JaimeBravoAlgaba/Helios_SoftRobot/Media/Imágenes/Sensor/WaveGuides/MatlabAnalysis/Core_45.png

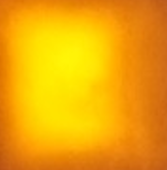
Media/Imágenes/Sensor/WaveGuides/MatlabAnalysis/Core_45.png
