JaimeBravoAlgaba/Helios_SoftRobot/Media/Imágenes/Sensor/WaveGuides/MatlabAnalysis/Cladding_60.png

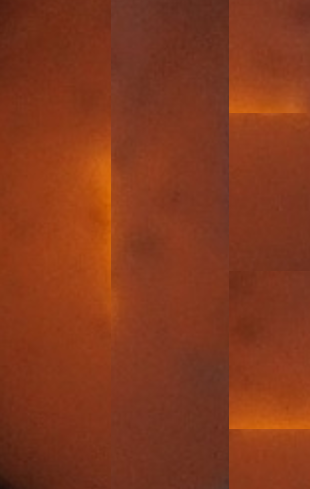
Media/Imágenes/Sensor/WaveGuides/MatlabAnalysis/Cladding_60.png
