JaimeBravoAlgaba/Helios_SoftRobot/Electrónica/Helios/Helios_PCB/Helios_emt/Helios_emt.png

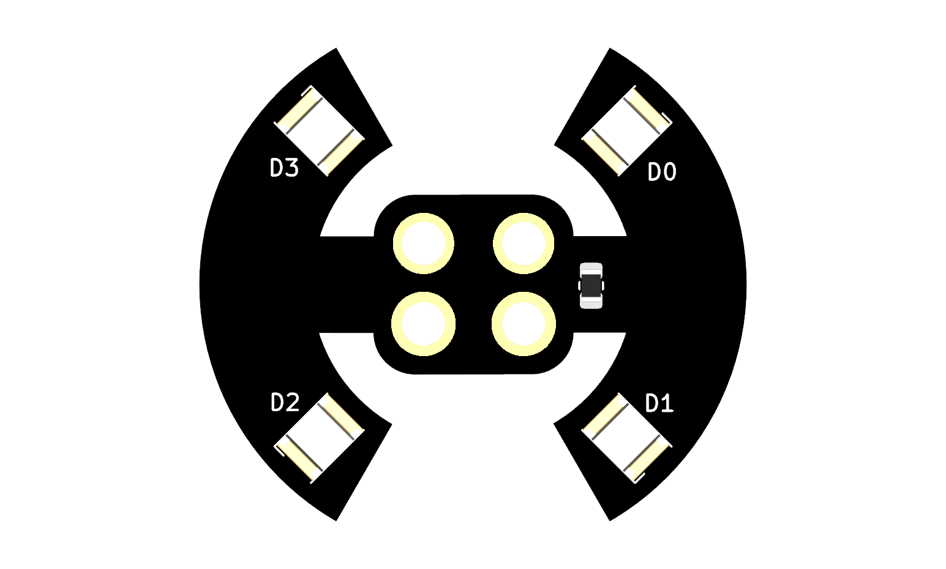
Electrónica/Helios/Helios_PCB/Helios_emt/Helios_emt.png
