JaimeBravoAlgaba/Helios_SoftRobot/Media/Imágenes/Actuator/HeliosActuator_explosionado.jpg

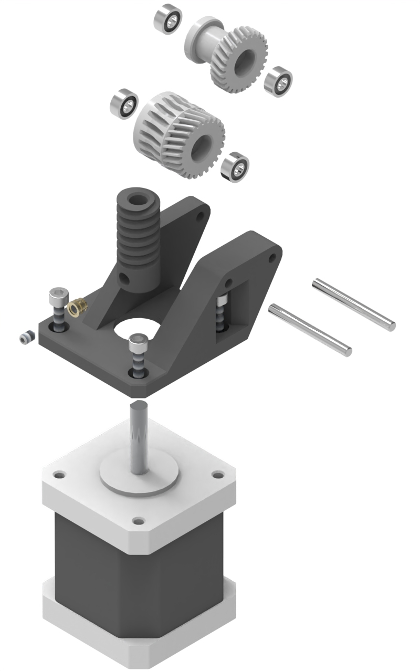
Media/Imágenes/Actuator/HeliosActuator_explosionado.jpg
