JaimeBravoAlgaba/Helios_SoftRobot/Media/Imágenes/Actuator/HeliosActuator_iso.jpg

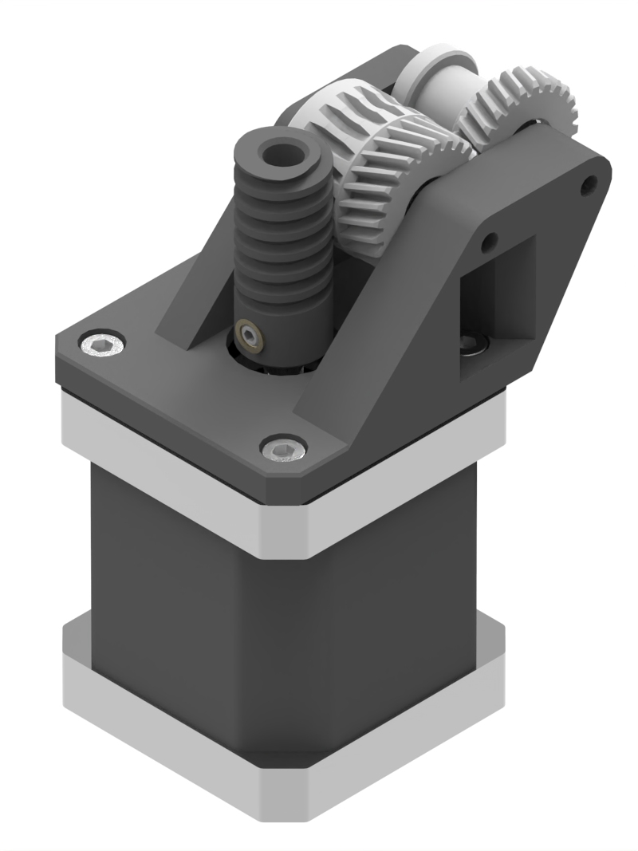
Media/Imágenes/Actuator/HeliosActuator_iso.jpg
