JaimeBravoAlgaba/Helios_SoftRobot/Media/Imágenes/Actuator/HeliosActuator_iso_2.jpg

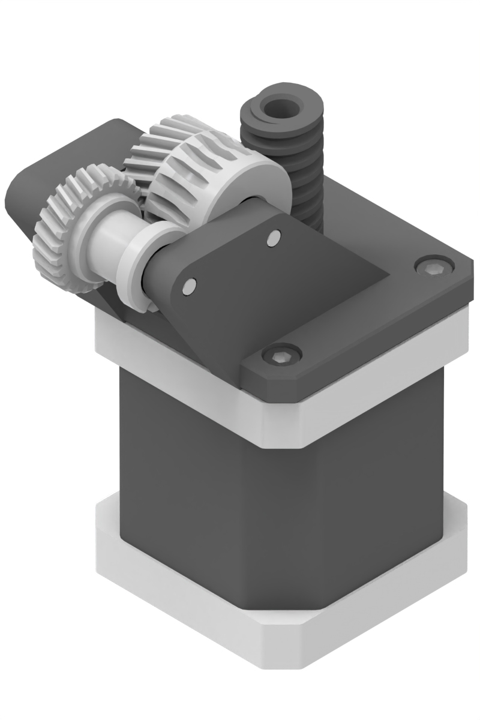
Media/Imágenes/Actuator/HeliosActuator_iso_2.jpg
