JaimeBravoAlgaba/Helios_SoftRobot/Media/Imágenes/Banco de Motores/BancodeMotores.jpg

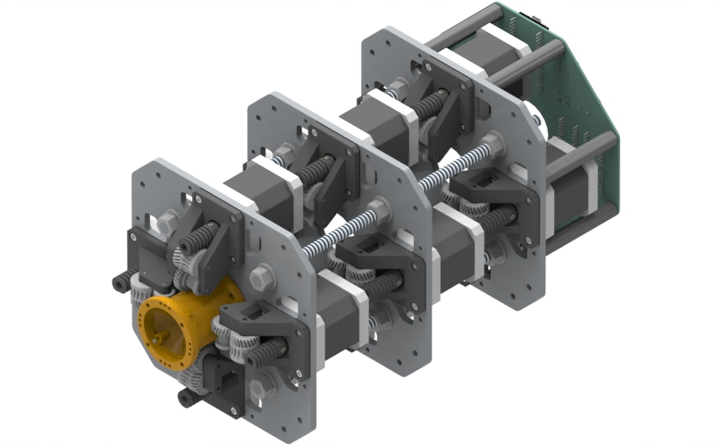
Media/Imágenes/Banco de Motores/BancodeMotores.jpg
