JaimeBravoAlgaba/Helios_SoftRobot/Media/Imágenes/Banco de Motores/BancodeMotores_back.jpg

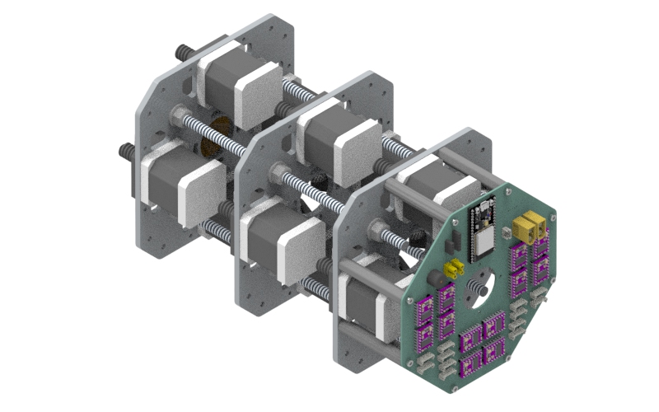
Media/Imágenes/Banco de Motores/BancodeMotores_back.jpg
