JaimeBravoAlgaba/Helios_SoftRobot/Media/Imágenes/HeliosPanel/Helios_PCB_panel.png

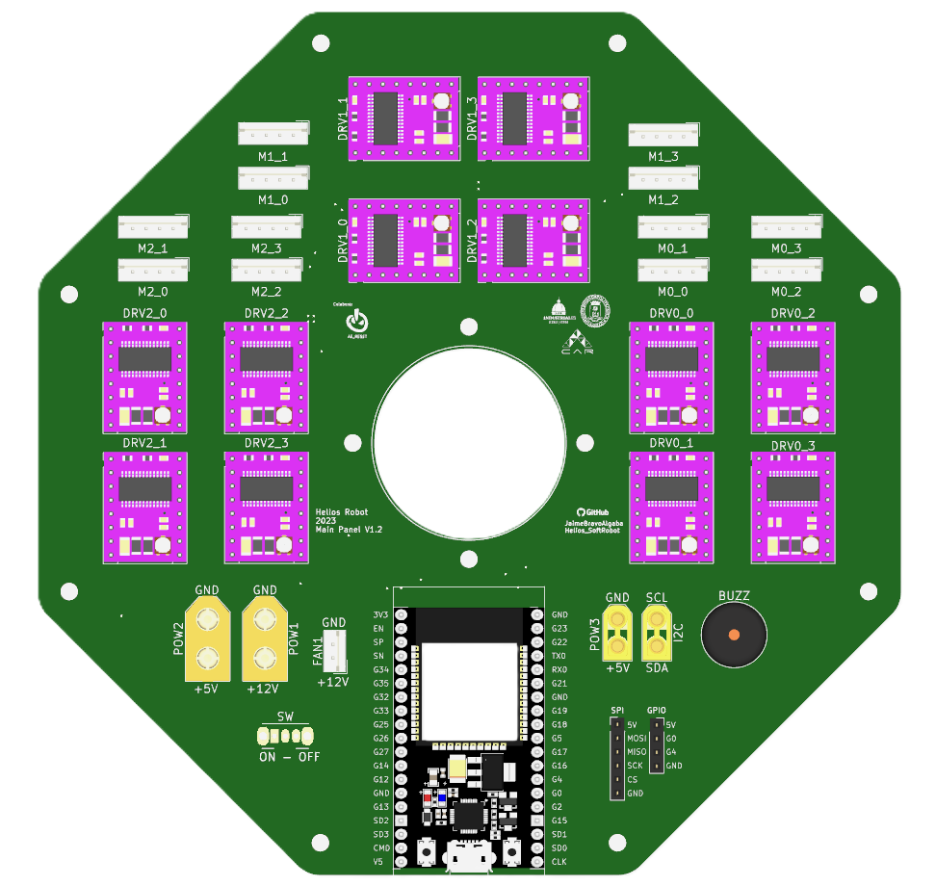
Media/Imágenes/HeliosPanel/Helios_PCB_panel.png
