JaimeBravoAlgaba/Helios_SoftRobot/Media/Imágenes/IMU/HeliosIMU.jpg

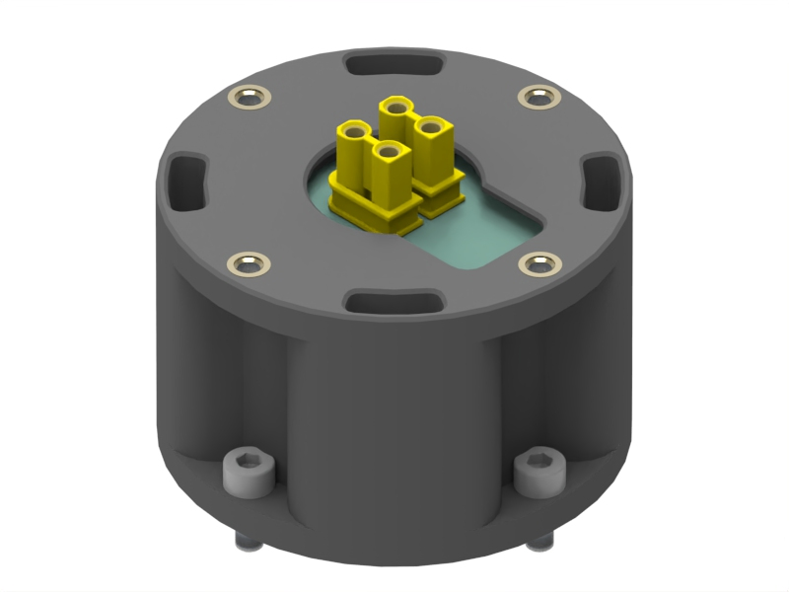
Media/Imágenes/IMU/HeliosIMU.jpg
