JaimeBravoAlgaba/Helios_SoftRobot/Media/Imágenes/IMU/HeliosIMU_exp.jpg

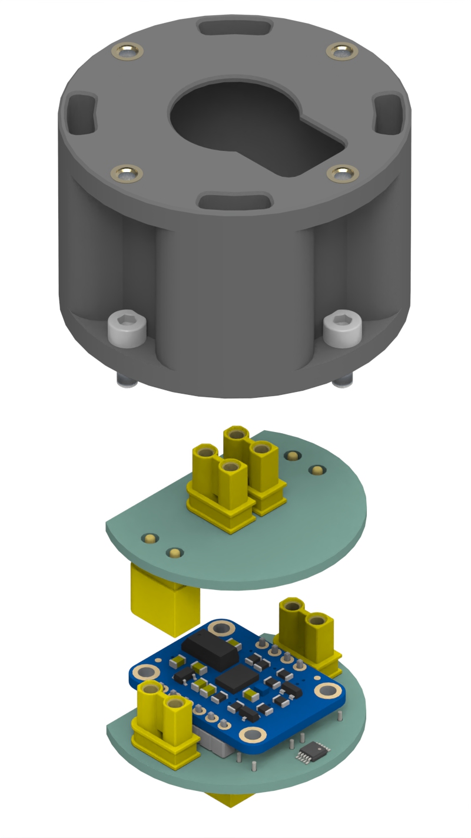
Media/Imágenes/IMU/HeliosIMU_exp.jpg
