JaimeBravoAlgaba/Helios_SoftRobot/Media/Imágenes/Sensor/DSC03742.JPG

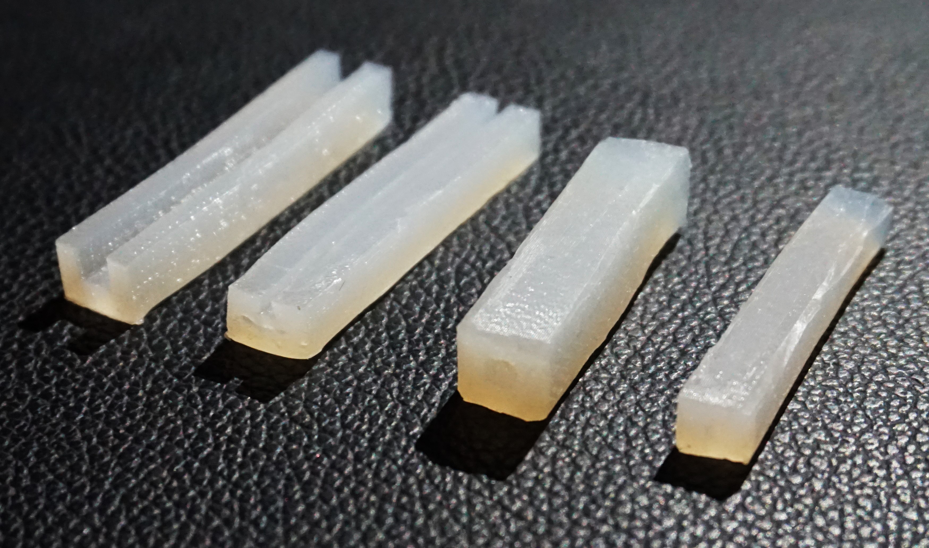
Media/Imágenes/Sensor/DSC03742.JPG
