JaimeBravoAlgaba/Helios_SoftRobot/Media/Imágenes/Sensor/explosionado.jpg

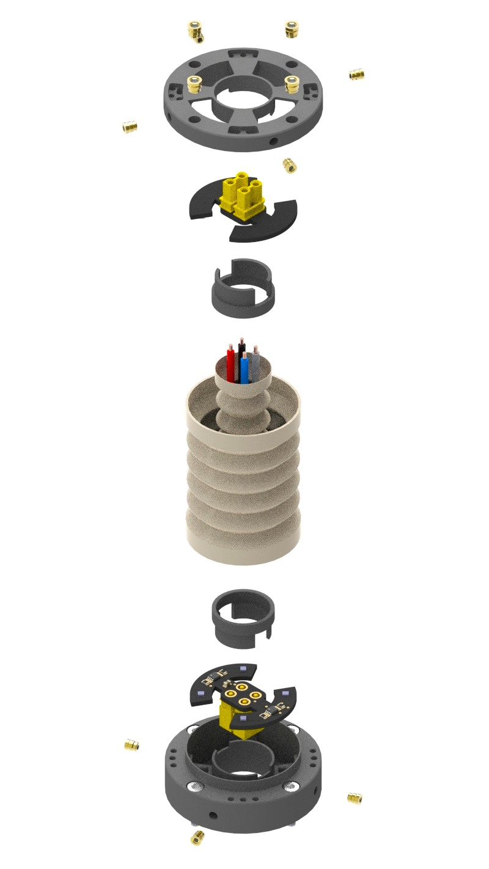
Media/Imágenes/Sensor/explosionado.jpg
