JaimeBravoAlgaba/Helios_SoftRobot/Media/Imágenes/Sensor/explosionado.png

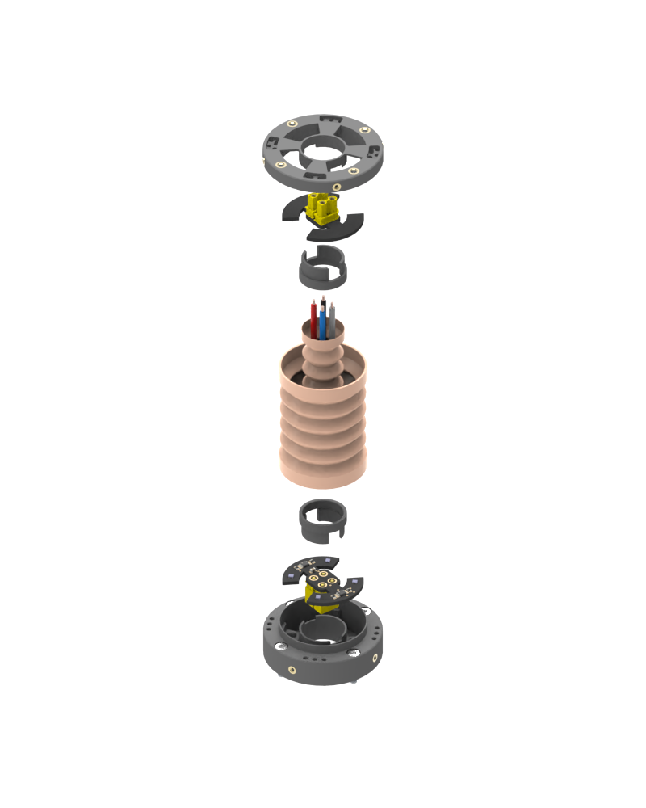
Media/Imágenes/Sensor/explosionado.png
