JaimeBravoAlgaba/Helios_SoftRobot/Media/Imágenes/Sensor/FuellesFlexibles.png

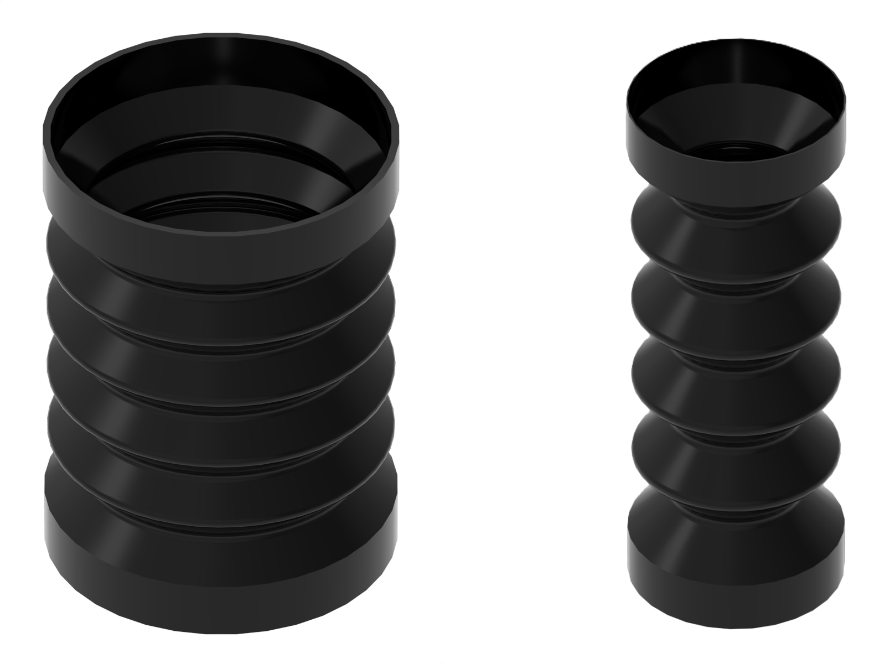
Media/Imágenes/Sensor/FuellesFlexibles.png
