JaimeBravoAlgaba/Helios_SoftRobot/Media/Imágenes/Sensor/Helios_emt/DiscoHembra_cut.jpg

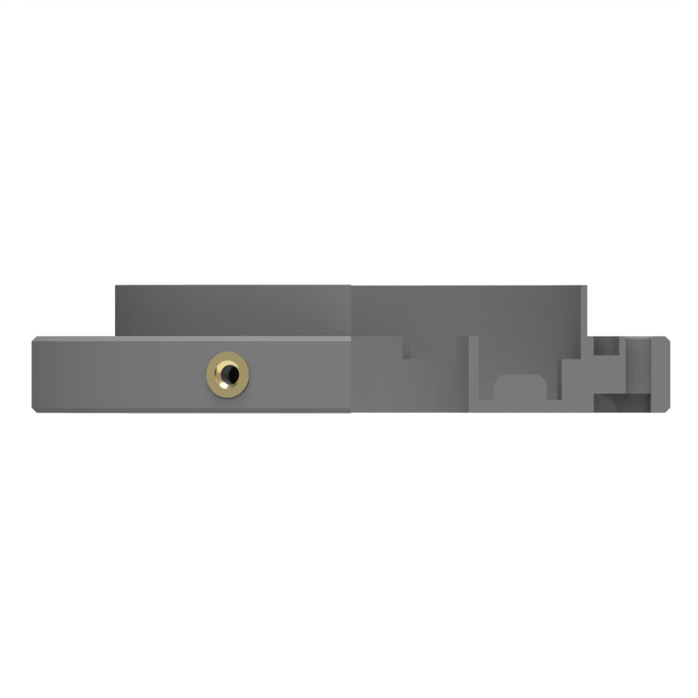
Media/Imágenes/Sensor/Helios_emt/DiscoHembra_cut.jpg
