JaimeBravoAlgaba/Helios_SoftRobot/Media/Imágenes/Sensor/Helios_emt/DiscoHembra_iso.jpg

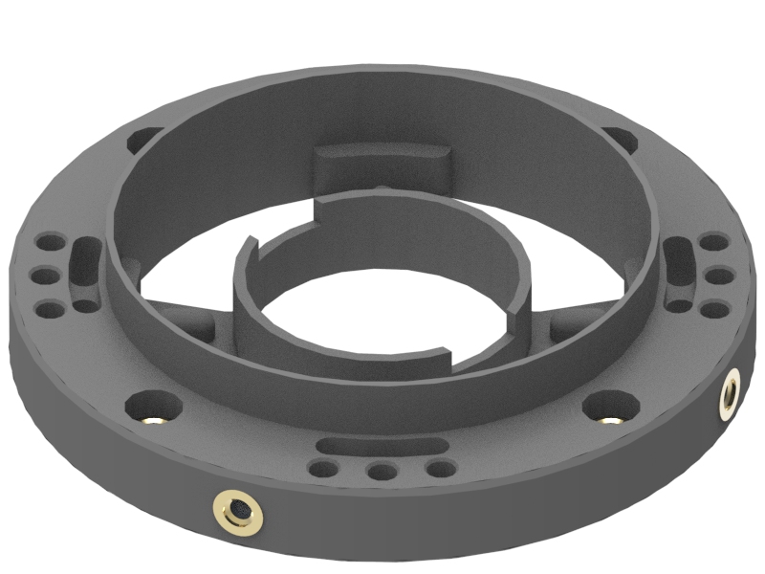
Media/Imágenes/Sensor/Helios_emt/DiscoHembra_iso.jpg
