JaimeBravoAlgaba/Helios_SoftRobot/Media/Imágenes/Sensor/Helios_emt/DiscoHembra_top.8.jpg

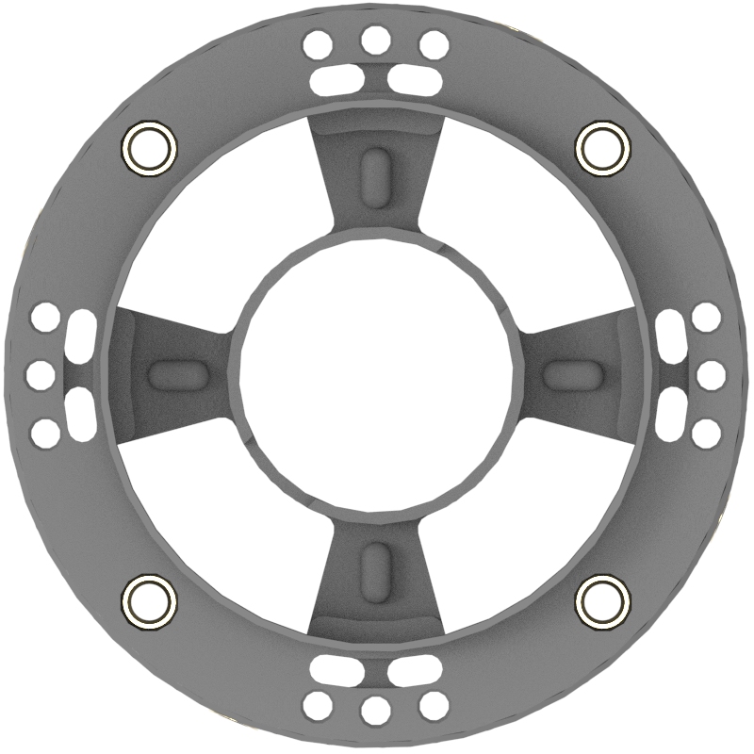
Media/Imágenes/Sensor/Helios_emt/DiscoHembra_top.8.jpg
