JaimeBravoAlgaba/Helios_SoftRobot/Media/Imágenes/Sensor/Helios_Iter2_Dims.png

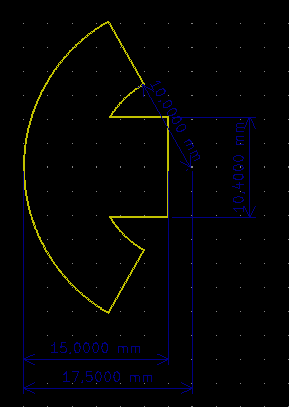
Media/Imágenes/Sensor/Helios_Iter2_Dims.png
