JaimeBravoAlgaba/Helios_SoftRobot/Media/Imágenes/Sensor/Helios_Module_Rev1.png

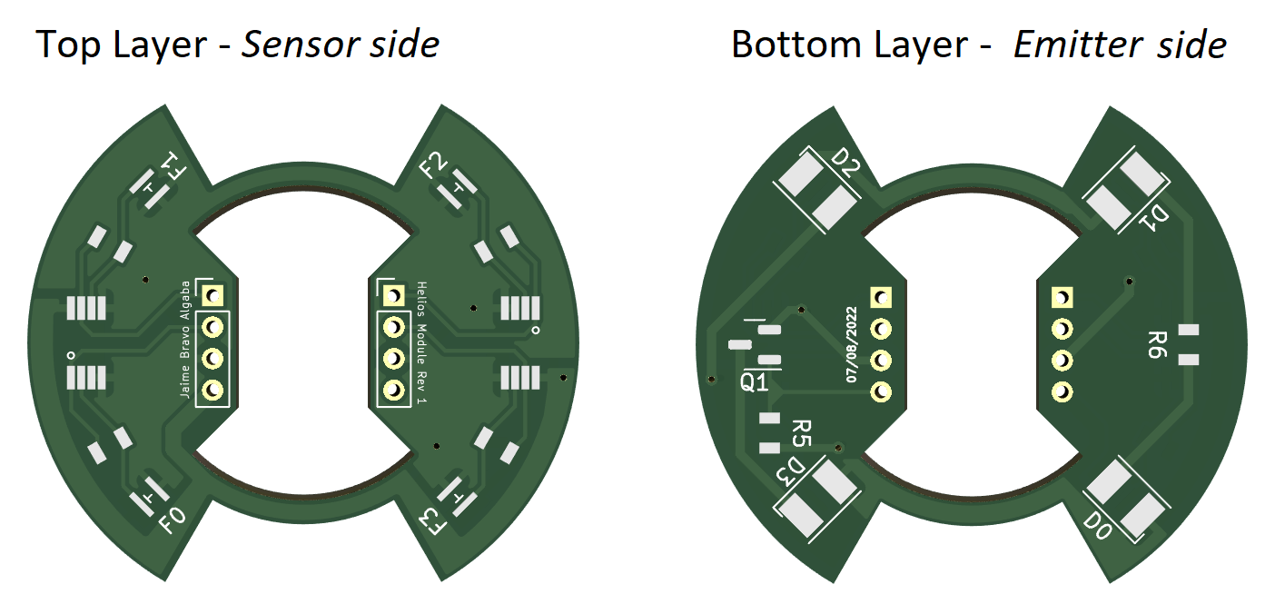
Media/Imágenes/Sensor/Helios_Module_Rev1.png
