JaimeBravoAlgaba/Helios_SoftRobot/Media/Imágenes/Sensor/Helios_Module_Rev1_Iter2.png

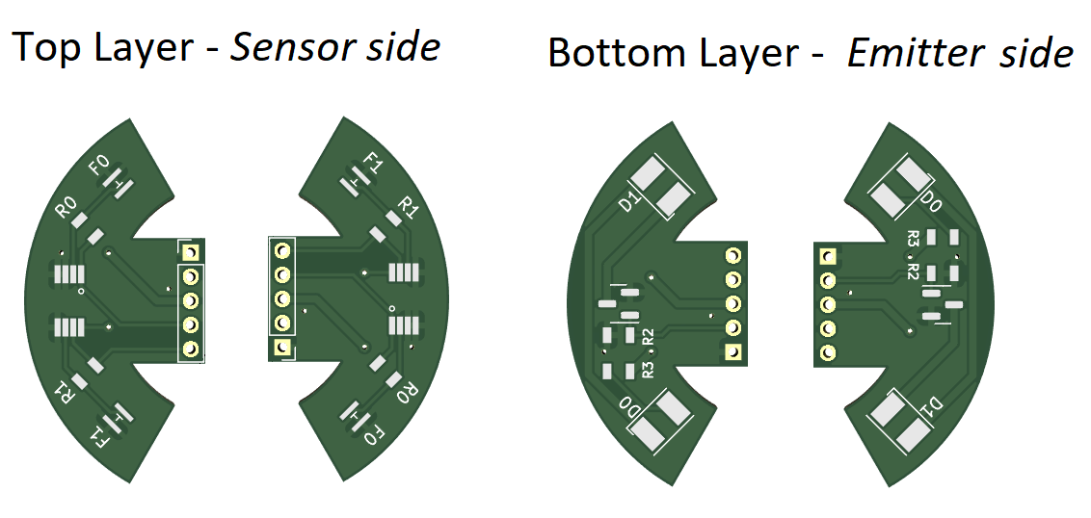
Media/Imágenes/Sensor/Helios_Module_Rev1_Iter2.png
