JaimeBravoAlgaba/Helios_SoftRobot/Media/Imágenes/Sensor/Helios_Module_V1.3.png

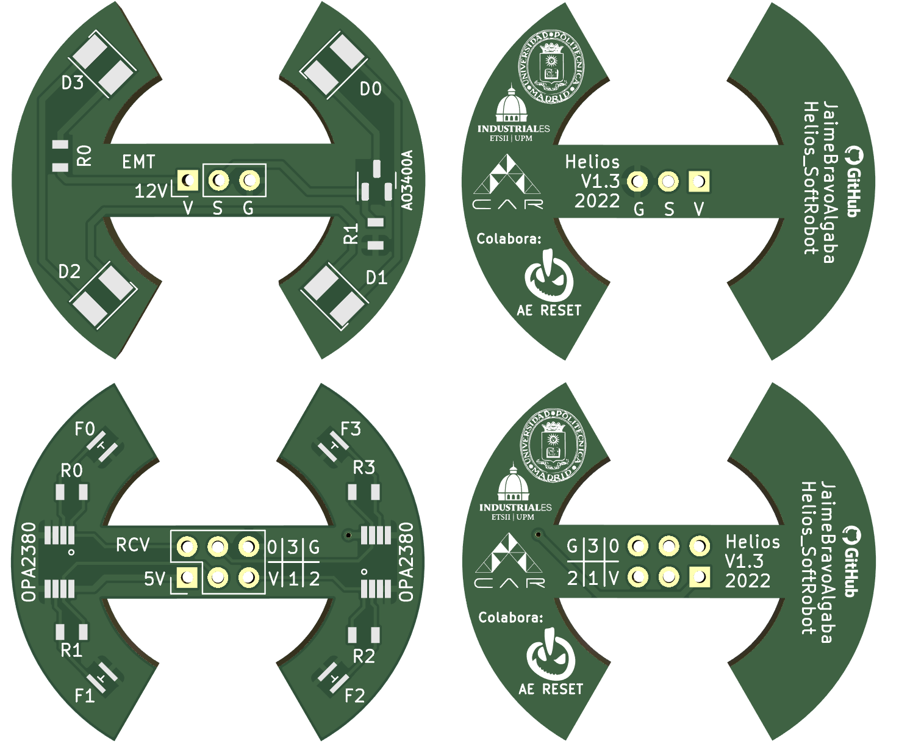
Media/Imágenes/Sensor/Helios_Module_V1.3.png
