JaimeBravoAlgaba/Helios_SoftRobot/Media/Imágenes/Sensor/Helios_rcv/DiscoMacho_descripción.jpg

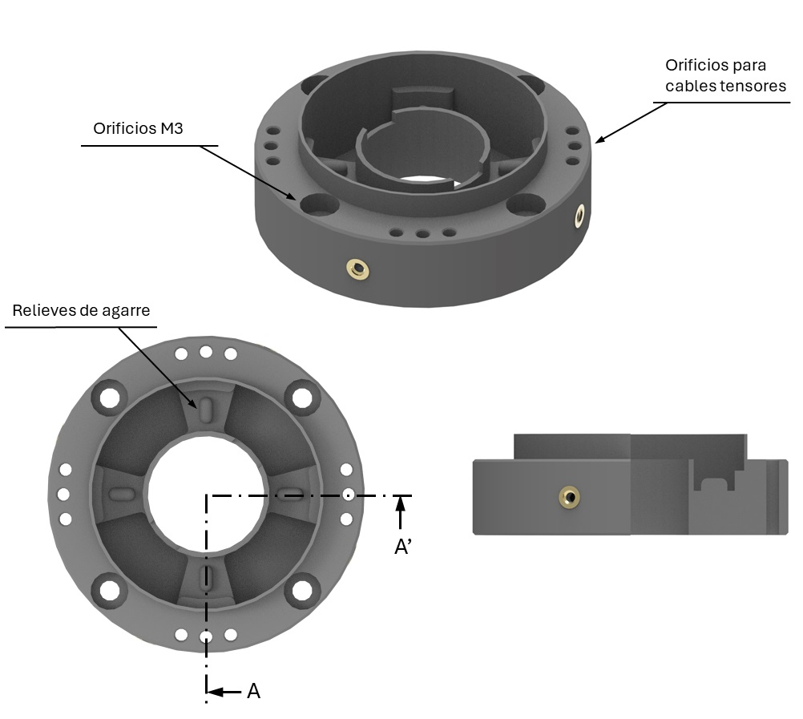
Media/Imágenes/Sensor/Helios_rcv/DiscoMacho_descripción.jpg
