JaimeBravoAlgaba/Helios_SoftRobot/Media/Imágenes/Sensor/Helios_rcv/DiscoMacho_iso.jpg

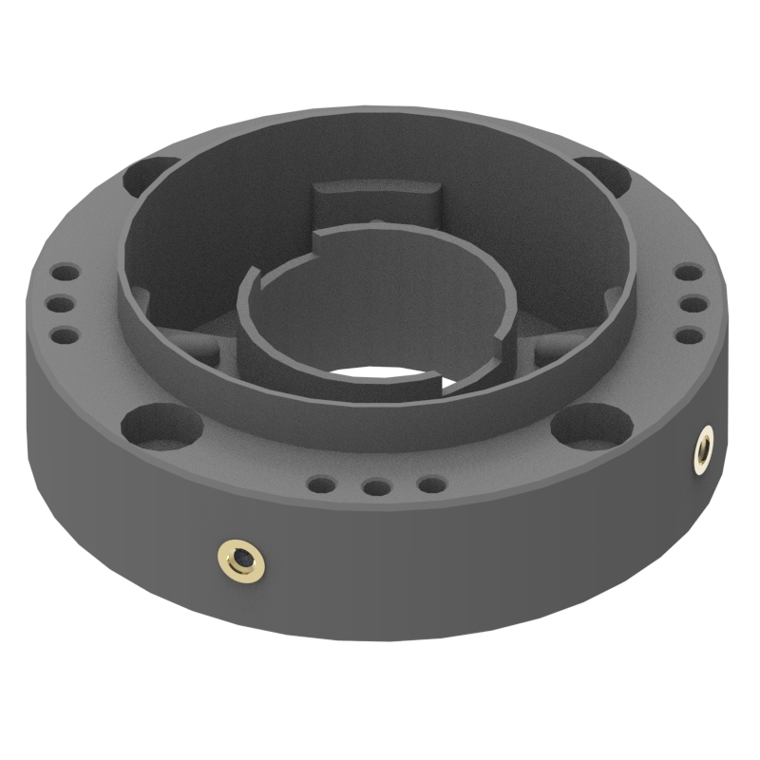
Media/Imágenes/Sensor/Helios_rcv/DiscoMacho_iso.jpg
