JaimeBravoAlgaba/Helios_SoftRobot/Media/Imágenes/Sensor/Helios_rcv/DiscoMacho_side.jpg

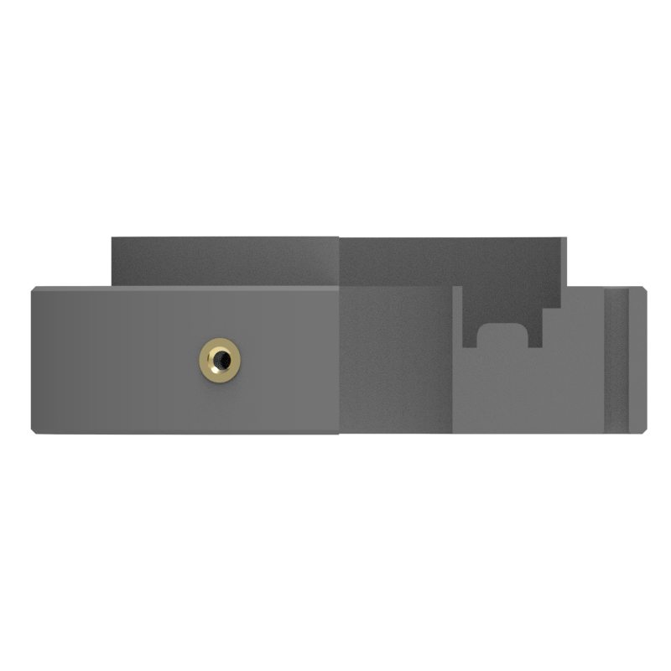
Media/Imágenes/Sensor/Helios_rcv/DiscoMacho_side.jpg
