JaimeBravoAlgaba/Helios_SoftRobot/Media/Imágenes/Sensor/Helios_rcv/DiscoMacho_top.jpg

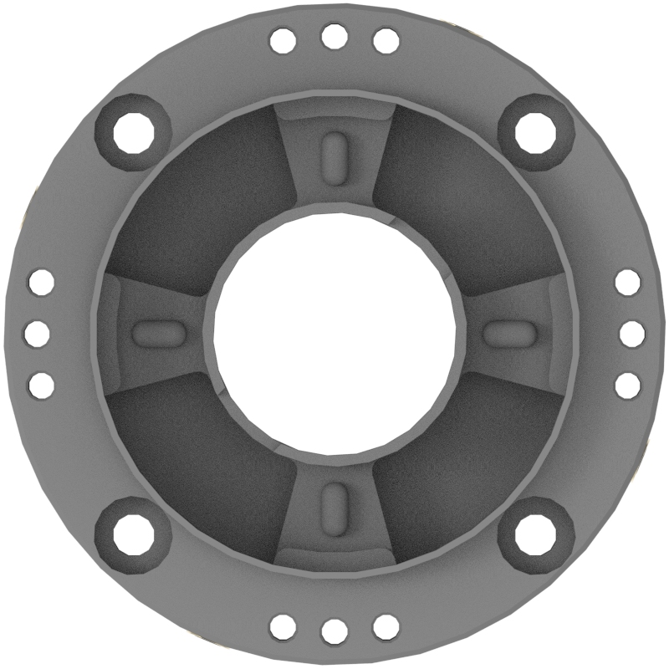
Media/Imágenes/Sensor/Helios_rcv/DiscoMacho_top.jpg
