JaimeBravoAlgaba/Helios_SoftRobot/Media/Imágenes/Sensor/Helios_rcv/Helios_rcv_render.png

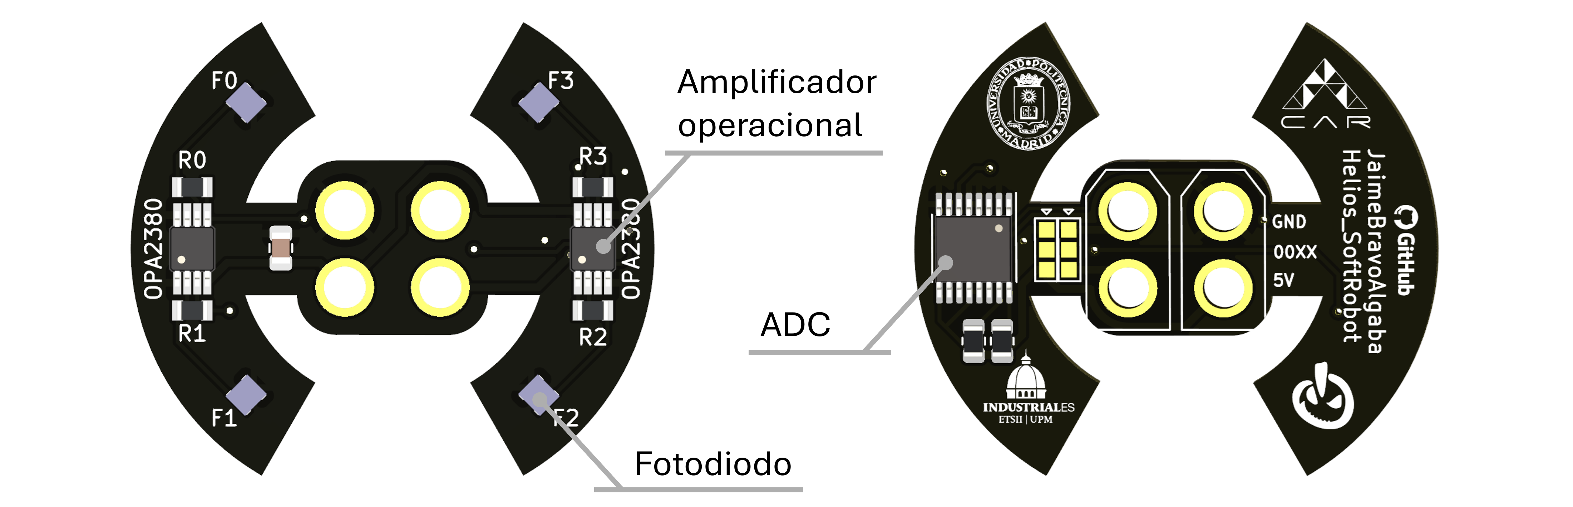
Media/Imágenes/Sensor/Helios_rcv/Helios_rcv_render.png
