JaimeBravoAlgaba/Helios_SoftRobot/Media/Imágenes/Sensor/Helios_rcv/i2c_config.png

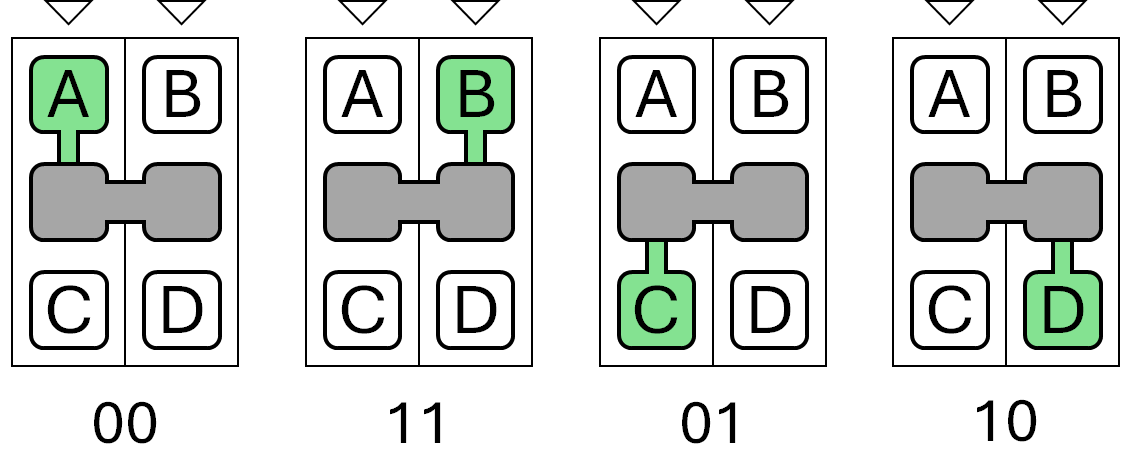
Media/Imágenes/Sensor/Helios_rcv/i2c_config.png
