JaimeBravoAlgaba/Helios_SoftRobot/Media/Imágenes/Sensor/Helios_top_render.png

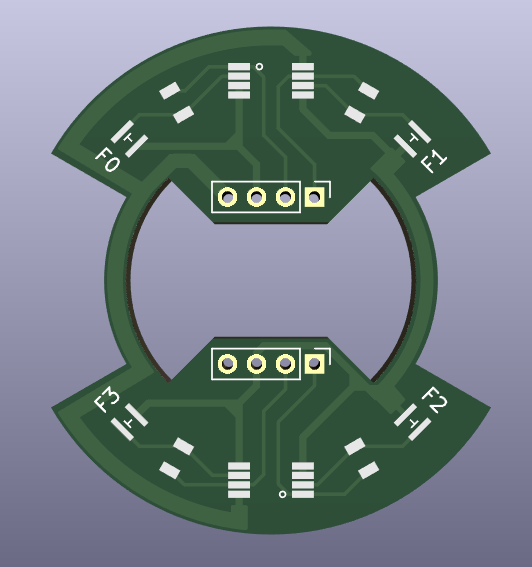
Media/Imágenes/Sensor/Helios_top_render.png
