JaimeBravoAlgaba/Helios_SoftRobot/Media/Imágenes/Sensor/HeliosConcept.png

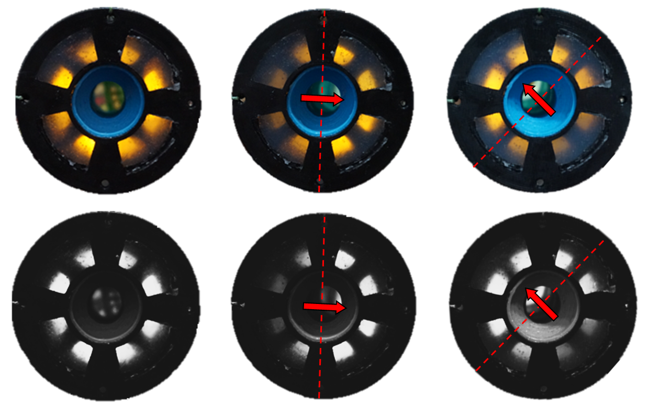
Media/Imágenes/Sensor/HeliosConcept.png
