JaimeBravoAlgaba/Helios_SoftRobot/Media/Imágenes/Sensor/HeliosModule_section.jpg

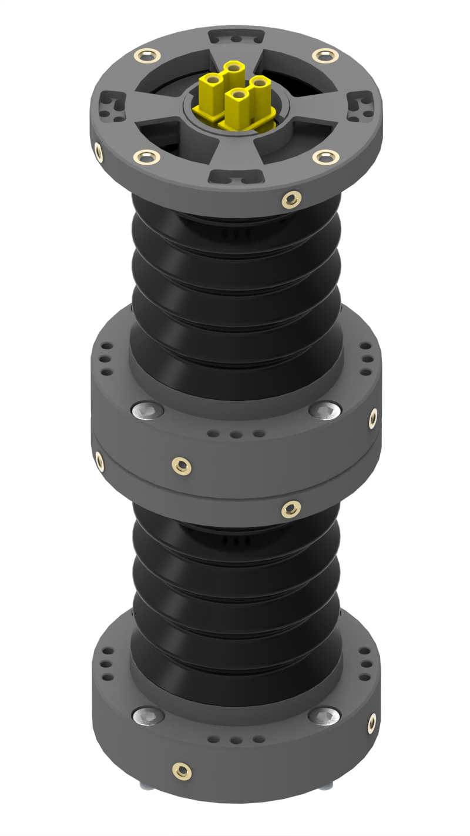
Media/Imágenes/Sensor/HeliosModule_section.jpg
