JaimeBravoAlgaba/Helios_SoftRobot/Media/Imágenes/Sensor/OPA2380_Pinout.png

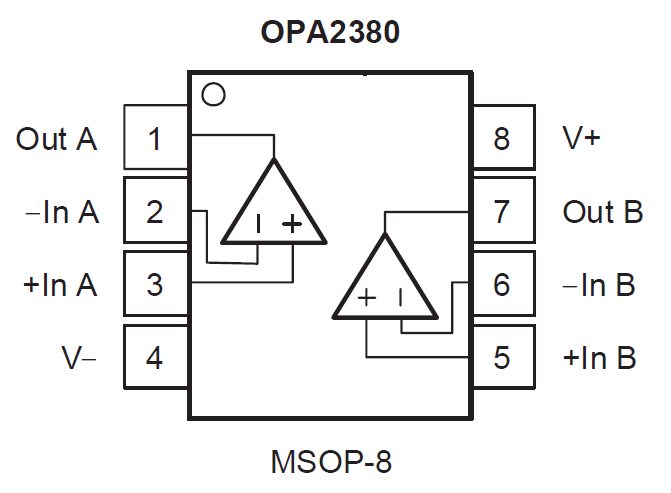
Media/Imágenes/Sensor/OPA2380_Pinout.png
