JaimeBravoAlgaba/Helios_SoftRobot/Media/Imágenes/Sensor/PanelPCB.png

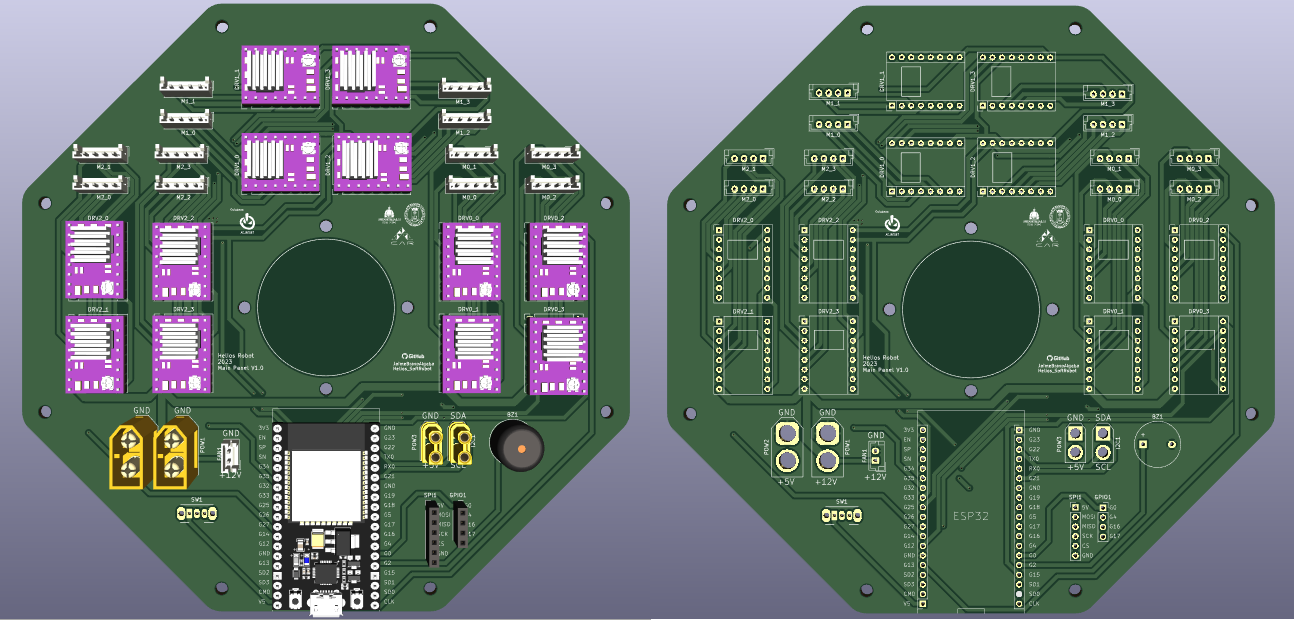
Media/Imágenes/Sensor/PanelPCB.png
