JaimeBravoAlgaba/Helios_SoftRobot/Media/Imágenes/Sensor/proMiniPinout.png

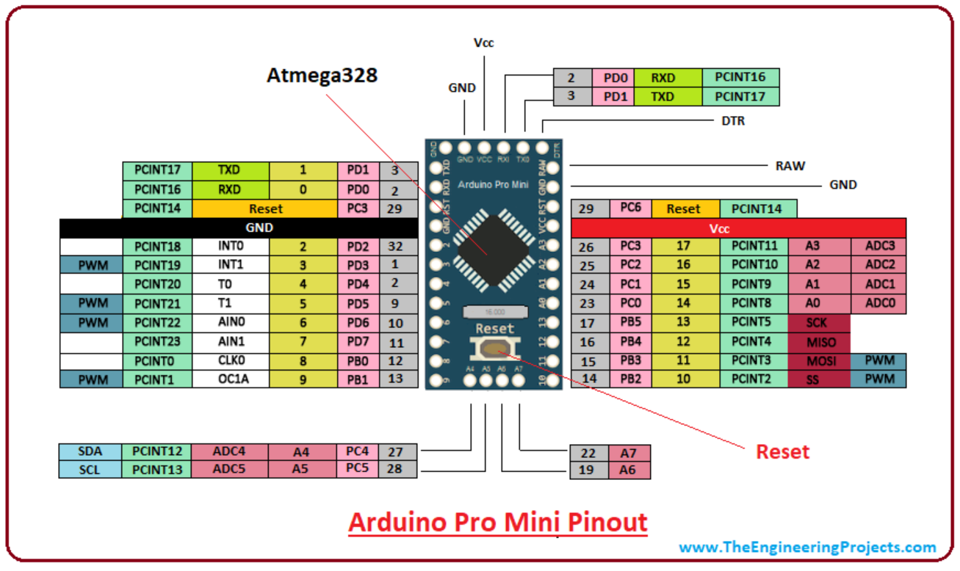
Media/Imágenes/Sensor/proMiniPinout.png
