JaimeBravoAlgaba/Helios_SoftRobot/Media/Imágenes/Tool/HeliosClaw.jpg

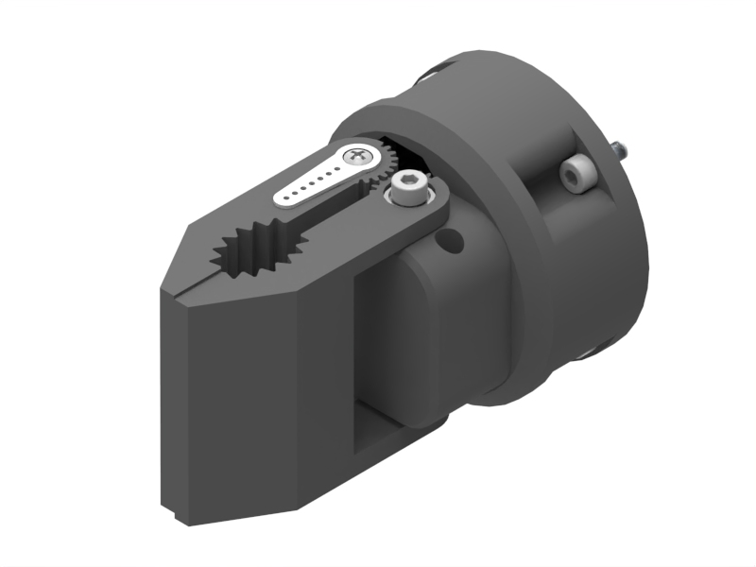
Media/Imágenes/Tool/HeliosClaw.jpg
