JaimeBravoAlgaba/Helios_SoftRobot/Media/Imágenes/Tool/HeliosClaw_exp1.jpg

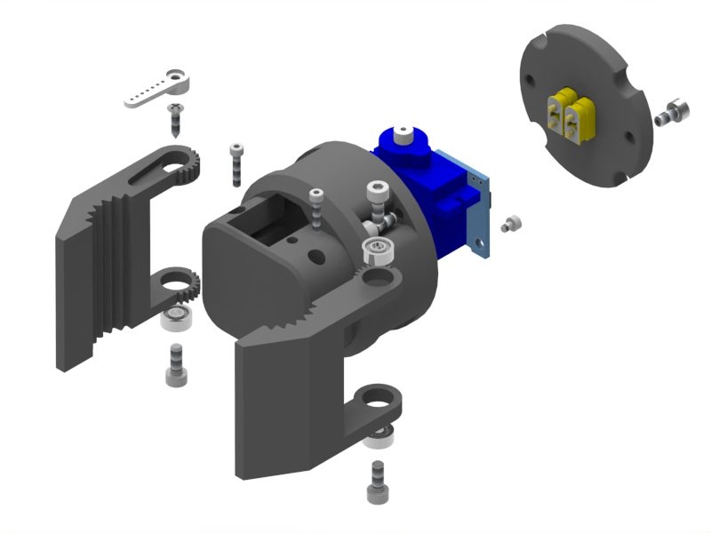
Media/Imágenes/Tool/HeliosClaw_exp1.jpg
