JaimeBravoAlgaba/Helios_SoftRobot/Media/Imágenes/Tool/HeliosClaw_exp2.jpg

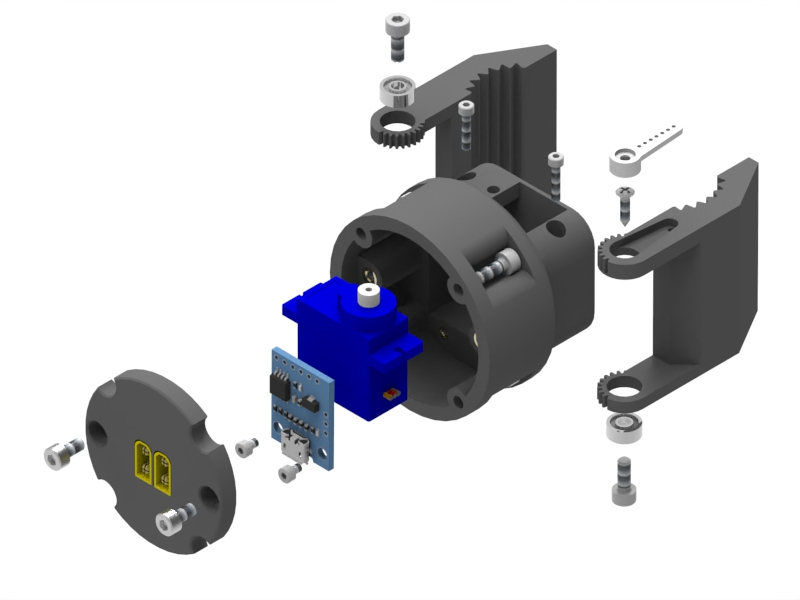
Media/Imágenes/Tool/HeliosClaw_exp2.jpg
