JaimeBravoAlgaba/Helios_SoftRobot/Media/Imágenes/Tool/HeliosClaw_open.jpg

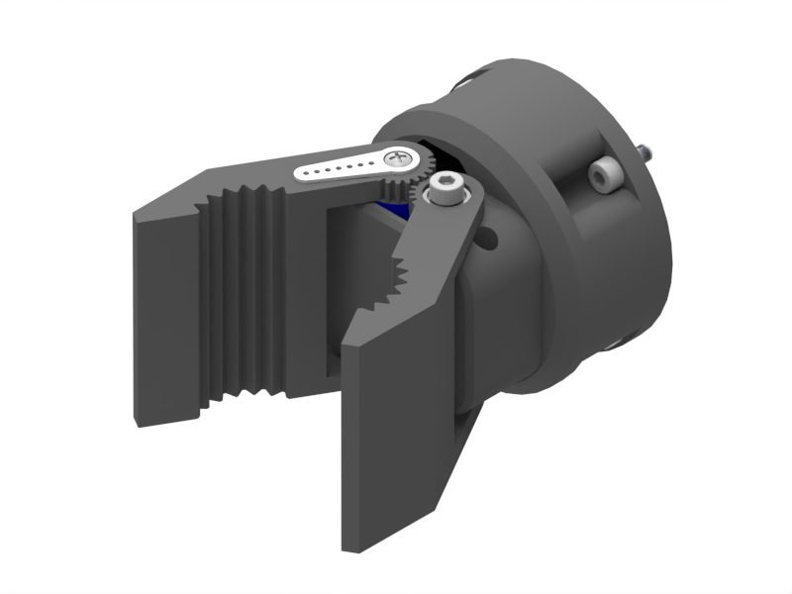
Media/Imágenes/Tool/HeliosClaw_open.jpg
