JaimeBravoAlgaba/Helios_SoftRobot/Electrónica/BOM_Helios.xlsx

HELIOS MODULE - BOM |  |  |  |  |  |  | EMITTER PCBs |  |  |  | 20
 |  |  |  |  |  |  | RECEIVER PCBs |  |  |  | 20
COMPONENT | PCB | DESCRIPTION | DATASHEET | QTTY. PER CIRCUIT | QTTY. TOTAL | QTTY. PER ORDER | TO ORDER | ORDER PRICE | SHIPPING COSTS | TOTAL PRICE | LINK
OPA2380 | RECEIVER | Transimpedance Amplifier | opa2380 | 2 | 40 | 10 | 4 | 12.77 | 0 | 51.08 | https://es.aliexpress.com/item/1005002651519658.html?curPageLogUid=3uJtDoBWpShc
SFH2704 | RECEIVER | Photodiode | sfh2704 | 4 | 80 | 20 | 4 | 29.12 |  | 116.48 | https://es.rs-online.com/web/p/circuitos-integrados-de-sensores-biometricos/1816802
2M RESISTOR | RECEIVER | Sensing Resistance |  | 4 | 80 |  | 0 | 0 | 0
OA3400 | EMITTER | Logic Level Mosfet | oa3400 | 1 | 20 | 50 | 1 | 0.91 | 1.1 | 2.01 | https://es.aliexpress.com/item/1005004174298809.html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
2K RESISTOR | EMITTER | Pulldown Resistance |  | 1 | 20 |  | 0 | 0 | 0 | 0
241 RESISTOR | EMITTER | Current Limiting Resistance |  | 1 | 20 |  | 0 | 0 | 0 | 0
