JaimeBravoAlgaba/Helios_SoftRobot/Modelos3D/Std_parts/Digispark Attiny85/Renders/1.jpg

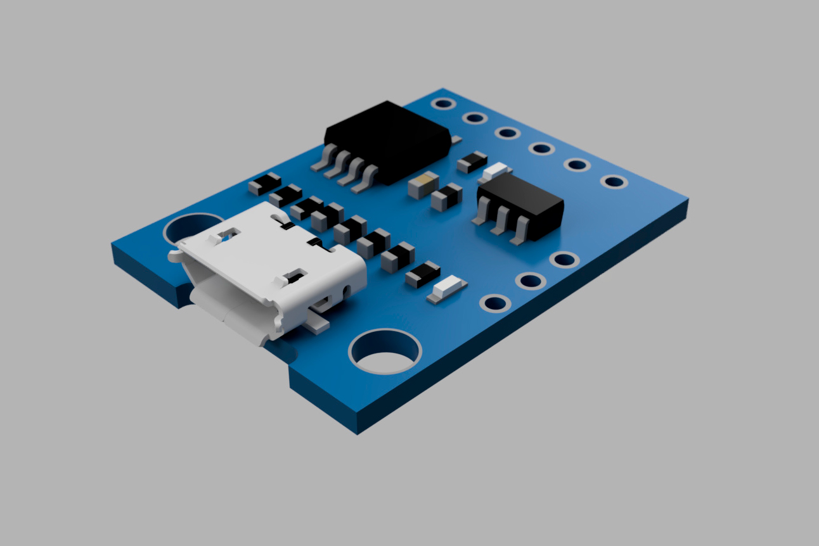
Modelos3D/Std_parts/Digispark Attiny85/Renders/1.jpg
