JaimeBravoAlgaba/Helios_SoftRobot/Modelos3D/Std_parts/Digispark Attiny85/Renders/4.jpg

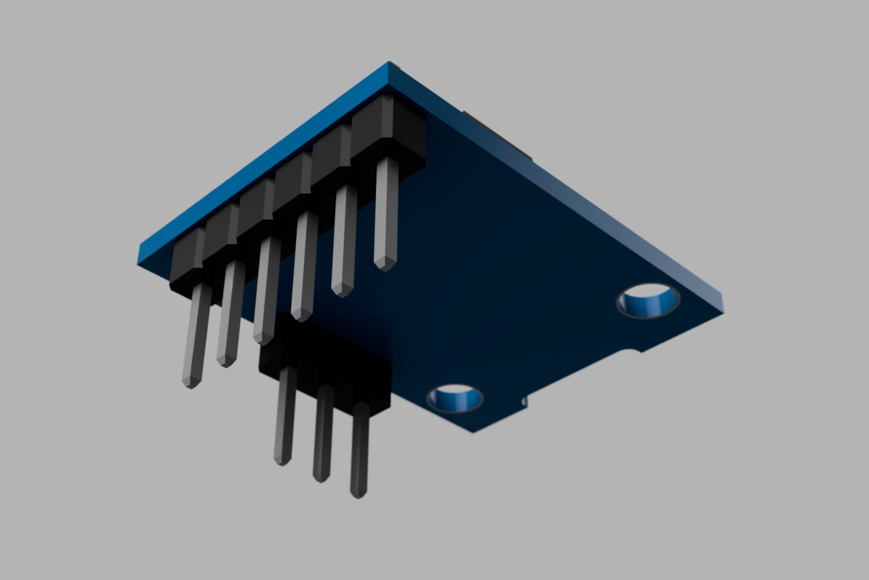
Modelos3D/Std_parts/Digispark Attiny85/Renders/4.jpg
