JaimeBravoAlgaba/Helios_SoftRobot/Modelos3D/Std_parts/tower-pro-sg90-micro-servo-2.snapshot.8/Renders/servoArmA3_render1.JPG

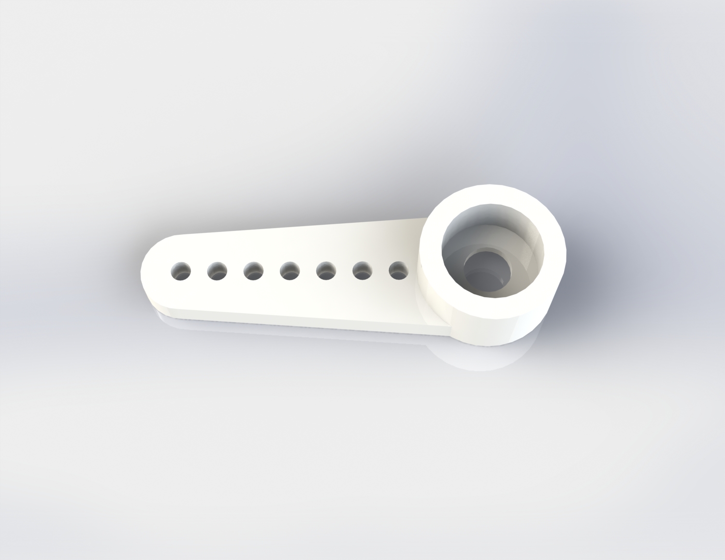
Modelos3D/Std_parts/tower-pro-sg90-micro-servo-2.snapshot.8/Renders/servoArmA3_render1.JPG
