JaimeBravoAlgaba/Helios_SoftRobot/Modelos3D/Std_parts/tower-pro-sg90-micro-servo-2.snapshot.8/STEP/microservoAssembly_A3.step

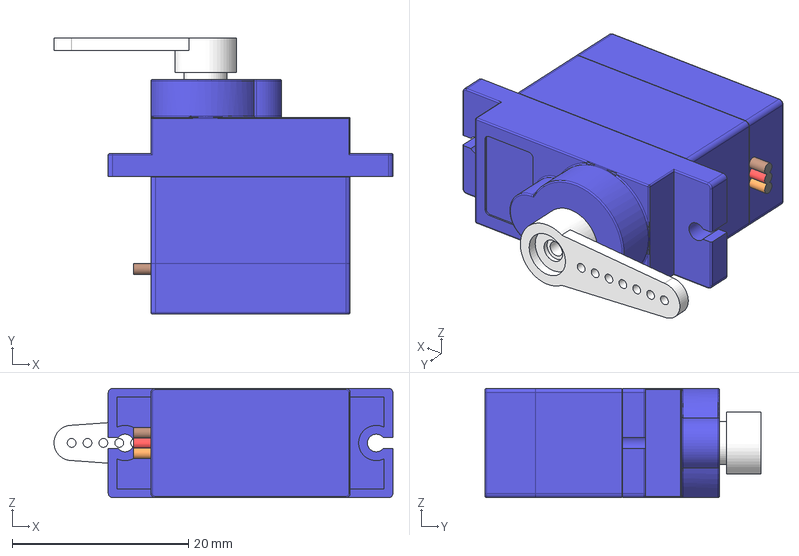
[picture p142: CAD file, 2024-08-19]
Modelos3D/Std_parts/tower-pro-sg90-micro-servo-2.snapshot.8/STEP/microservoAssembly_A3.step
38.4 x 31.3 x 12.4 mm
microservoSG90
microservoArm_A2
