JaimeBravoAlgaba/Helios_SoftRobot/Electrónica/KicadLibs/Helios/3dmodels/SFH_2704_20190402_geometry.STEP

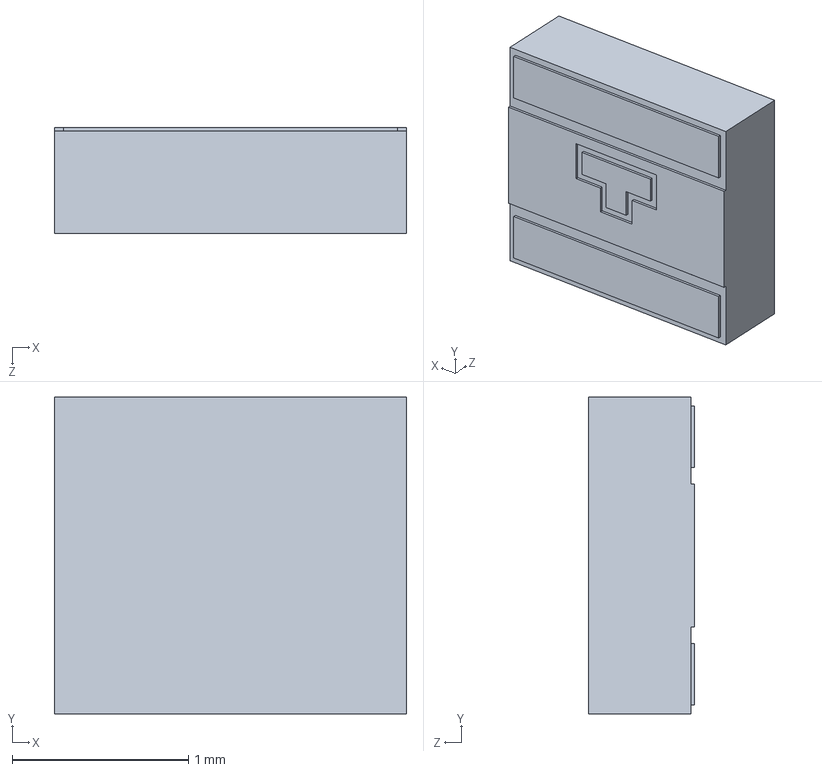
[picture p144: CAD file, 2022-07-25]
Electrónica/KicadLibs/Helios/3dmodels/SFH_2704_20190402_geometry.STEP
2.00 x 1.80 x 0.6 mm
