JaimeBravoAlgaba/Helios_SoftRobot/Modelos3D/Actuador/STL/CE3PRO_worm_gear.3mf

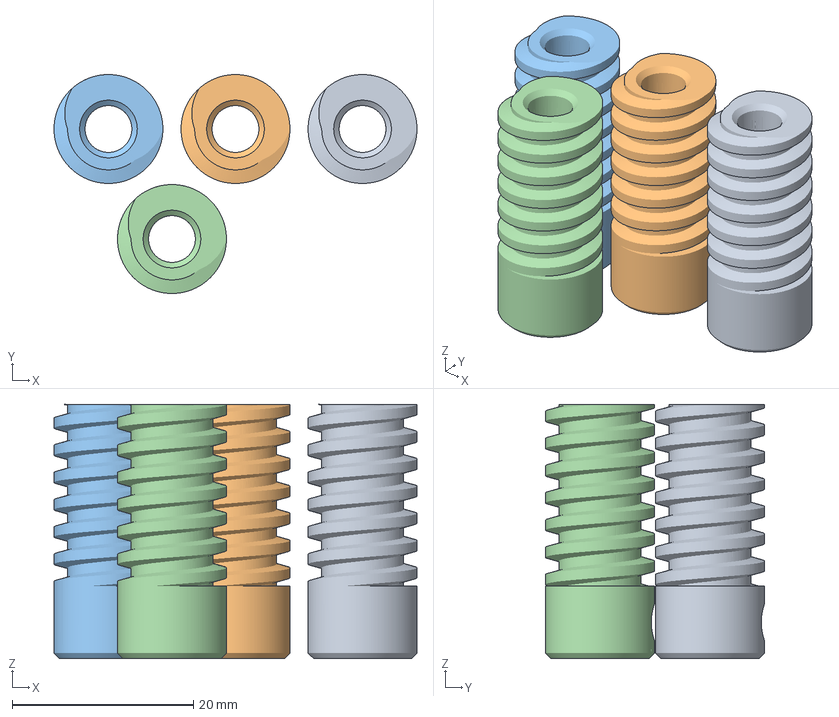
[picture p145: CAD file, 2024-12-06]
Modelos3D/Actuador/STL/CE3PRO_worm_gear.3mf
40.0 x 24.1 x 28.0 mm
worm_gear.stl x 4
