JaimeBravoAlgaba/Helios_SoftRobot/Modelos3D/BancoMotores/SoporteMotores.stp

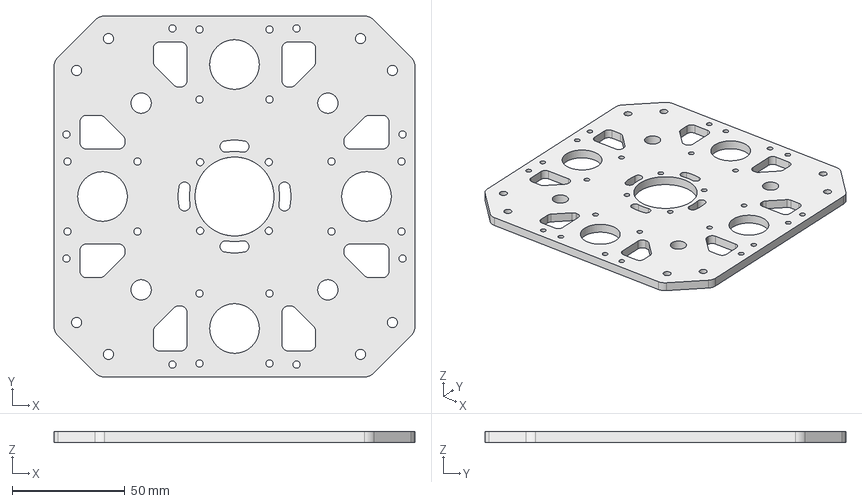
[picture p146: CAD file, 2024-01-28]
Modelos3D/BancoMotores/SoporteMotores.stp
160.0 x 160.0 x 5.00 mm
