JaimeBravoAlgaba/Helios_SoftRobot/Modelos3D/Modulo_Helios/Helios_Disk/STL/MeshBody1.3mf

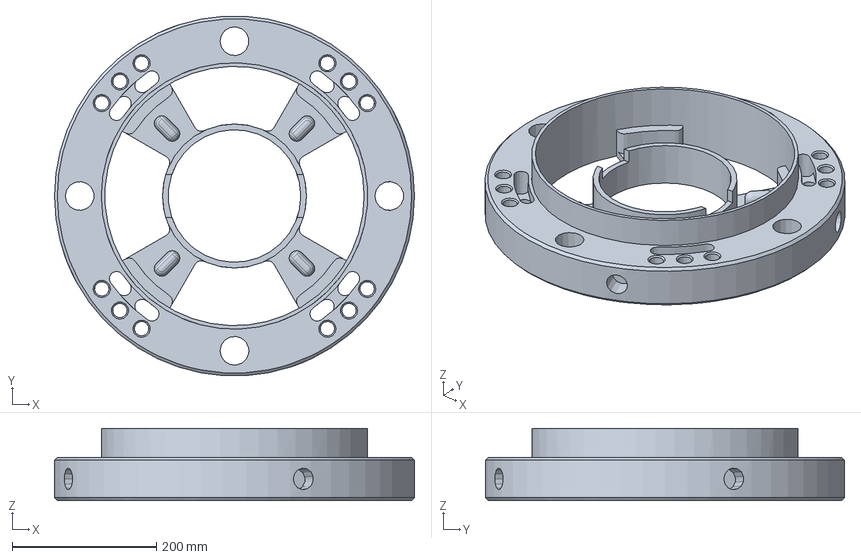
[picture p147: CAD file, 2024-08-04]
Modelos3D/Modulo_Helios/Helios_Disk/STL/MeshBody1.3mf
500.0 x 499.0 x 100.0 mm
