JaimeBravoAlgaba/Helios_SoftRobot/Modelos3D/Modulo_Helios/Helios_PCB/Helios_emt/STEP/Helios_emt.step

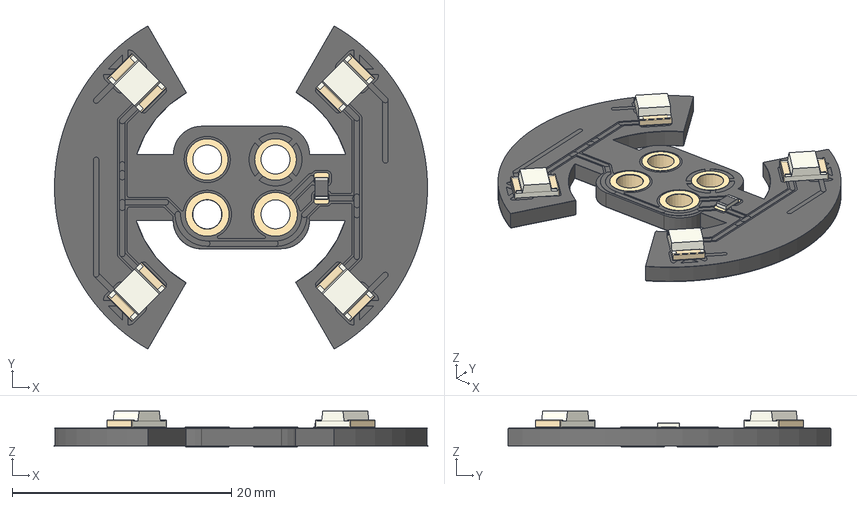
[picture p148: CAD file, 2024-08-04]
Modelos3D/Modulo_Helios/Helios_PCB/Helios_emt/STEP/Helios_emt.step
34.0 x 29.5 x 3.23 mm
LED_1812_4532Metric_1 x 4
R_0805_2012Metric_1
Helios_emt_track_1
Helios_emt_track_2
Helios_emt_track_3
Helios_emt_track_4
Helios_emt_track_5
Helios_emt_track_6
Helios_emt_track_7
Helios_emt_track_8
Helios_emt_track_9
Helios_emt_track_10
Helios_emt_track_11
Helios_emt_track_12
Helios_emt_track_13
Helios_emt_track_14
Helios_emt_track_15
Helios_emt_track_16
Helios_emt_track_17
Helios_emt_track_18
Helios_emt_track_19
Helios_emt_track_20
Helios_emt_track_21
Helios_emt_track_22
Helios_emt_track_23
Helios_emt_track_24
Helios_emt_track_25
Helios_emt_track_26
Helios_emt_track_27
Helios_emt_track_28
Helios_emt_track_29
Helios_emt_track_30
Helios_emt_track_31
Helios_emt_track_32
Helios_emt_track_33
Helios_emt_track_34
Helios_emt_track_35
Helios_emt_zone_1
Helios_emt_zone_2
Helios_emt_pad_1
Helios_emt_pad_2
Helios_emt_pad_3
Helios_emt_pad_4
Helios_emt_pad_5
Helios_emt_pad_6
Helios_emt_pad_7
Helios_emt_pad_8
Helios_emt_pad_9
Helios_emt_pad_10
Helios_emt_pad_11
Helios_emt_pad_12
Helios_emt_pad_13
Helios_emt_pad_14
Helios_emt_pad_15
Helios_emt_pad_16
Helios_emt_pad_17
Helios_emt_pad_18
Helios_emt_pad_19
Helios_emt_pad_20
Helios_emt_pad_21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
