JaimeBravoAlgaba/Helios_SoftRobot/Modelos3D/Modulo_Helios/Helios_PCB/Helios_rcv/STEP/Helios_rcv_00xx.step

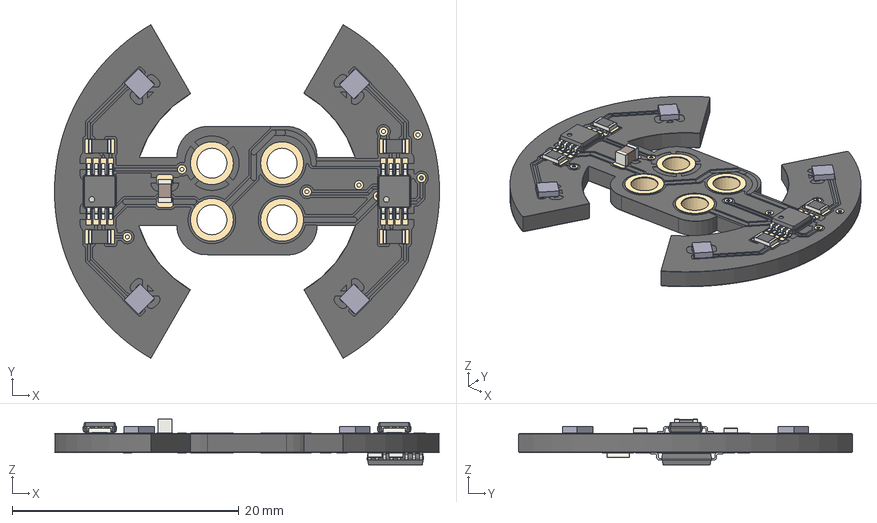
[picture p149: CAD file, 2024-08-04]
Modelos3D/Modulo_Helios/Helios_PCB/Helios_rcv/STEP/Helios_rcv_00xx.step
34.0 x 29.5 x 4.05 mm
MSOP_8_3x3mm_P065mm x 2
C_0805_2012Metric_1
R_0805_2012Metric_1 x 6
(Sin guardar) x 4
TSSOP_16_44x5mm_P065mm
Helios_rcv_00xx_track_1
Helios_rcv_00xx_track_2
Helios_rcv_00xx_track_3
Helios_rcv_00xx_track_4
Helios_rcv_00xx_track_5
Helios_rcv_00xx_track_6
Helios_rcv_00xx_track_7
Helios_rcv_00xx_track_8
Helios_rcv_00xx_track_9
Helios_rcv_00xx_track_10
Helios_rcv_00xx_track_11
Helios_rcv_00xx_track_12
Helios_rcv_00xx_track_13
Helios_rcv_00xx_track_14
Helios_rcv_00xx_track_15
Helios_rcv_00xx_track_16
Helios_rcv_00xx_track_17
Helios_rcv_00xx_track_18
Helios_rcv_00xx_track_19
Helios_rcv_00xx_track_20
Helios_rcv_00xx_track_21
Helios_rcv_00xx_track_22
Helios_rcv_00xx_track_23
Helios_rcv_00xx_track_24
Helios_rcv_00xx_track_25
Helios_rcv_00xx_track_26
Helios_rcv_00xx_track_27
Helios_rcv_00xx_track_28
Helios_rcv_00xx_track_29
Helios_rcv_00xx_track_30
Helios_rcv_00xx_track_31
Helios_rcv_00xx_track_32
Helios_rcv_00xx_track_33
Helios_rcv_00xx_track_34
Helios_rcv_00xx_track_35
Helios_rcv_00xx_track_36
Helios_rcv_00xx_track_37
Helios_rcv_00xx_track_38
Helios_rcv_00xx_track_39
Helios_rcv_00xx_track_40
Helios_rcv_00xx_track_41
Helios_rcv_00xx_track_42
Helios_rcv_00xx_track_43
Helios_rcv_00xx_track_44
Helios_rcv_00xx_track_45
Helios_rcv_00xx_track_46
Helios_rcv_00xx_track_47
Helios_rcv_00xx_track_48
Helios_rcv_00xx_track_49
Helios_rcv_00xx_track_50
Helios_rcv_00xx_track_51
Helios_rcv_00xx_track_52
Helios_rcv_00xx_track_53
Helios_rcv_00xx_track_54
Helios_rcv_00xx_track_55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
