JaimeBravoAlgaba/Helios_SoftRobot/Modelos3D/Modulo_IMU/STEP/Helios_IMU_M.step

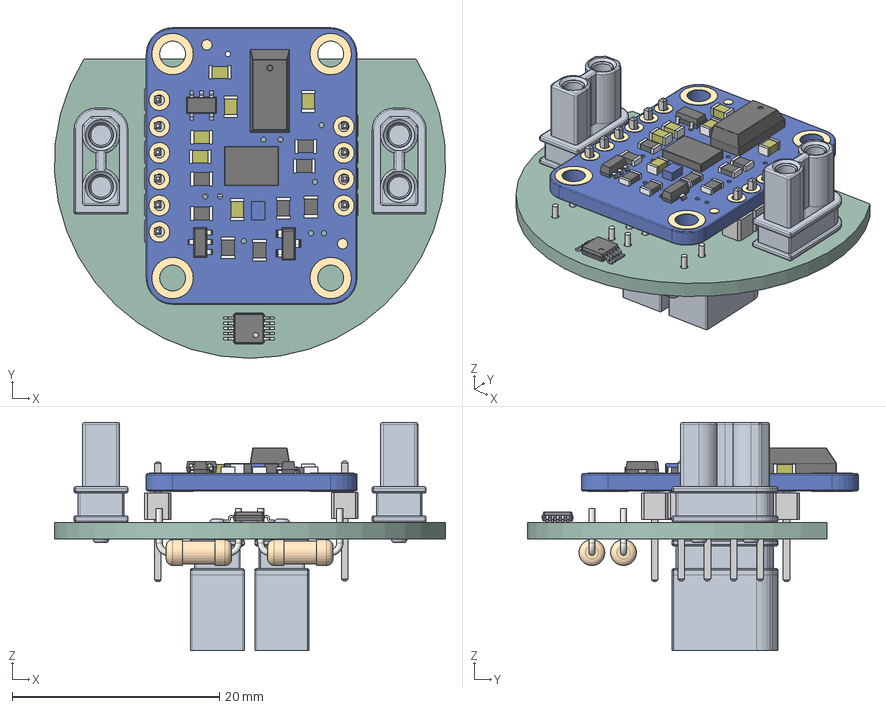
[picture p150: CAD file, 2024-08-19]
Modelos3D/Modulo_IMU/STEP/Helios_IMU_M.step
37.7 x 31.9 x 22.0 mm
ASSEMBLY x 4
(Sin guardar)
MSOP_10_3x3mm_P05mm
R_Axial_DIN0207_L63mm_D25mm_P762mm_Horizontal x 4
Helios_IMU_M_PCB
