JaimeBravoAlgaba/Helios_SoftRobot/Modelos3D/Panel/STEP/Helios_PCB_panel.step

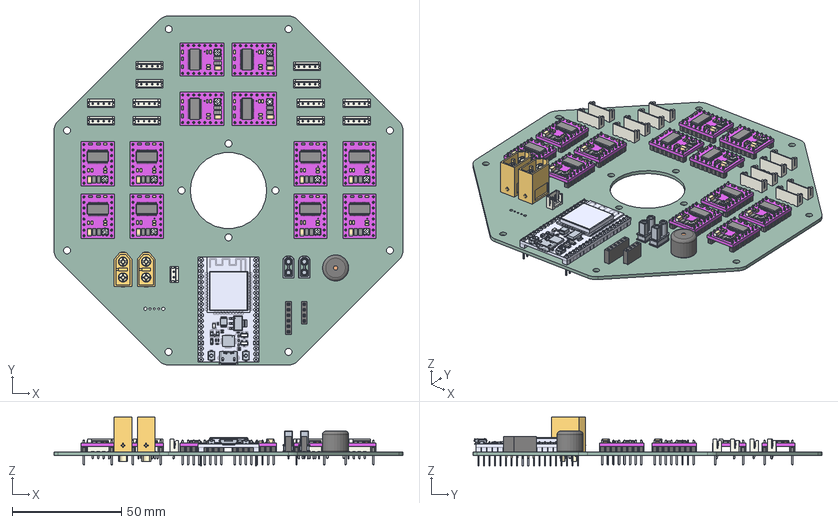
[picture p151: CAD file, 2024-08-13]
Modelos3D/Panel/STEP/Helios_PCB_panel.step
160.0 x 160.0 x 22.4 mm
XT60 male v9 x 2
(Sin guardar) x 12
JST_B4B_EH_A x 12
ASSEMBLY x 2
JST_B2B_EH_A
ESP32Wroom4
PinSocket_1x06_P254mm_Vertical
Buzzer_12x95RM76
PinSocket_1x04_P254mm_Vertical
Helios_PCB_panel_PCB
