JaimeBravoAlgaba/Helios_SoftRobot/Modelos3D/Std_parts/Digispark Attiny85/STEP/Digispark Attiny85 (with pin headers).step

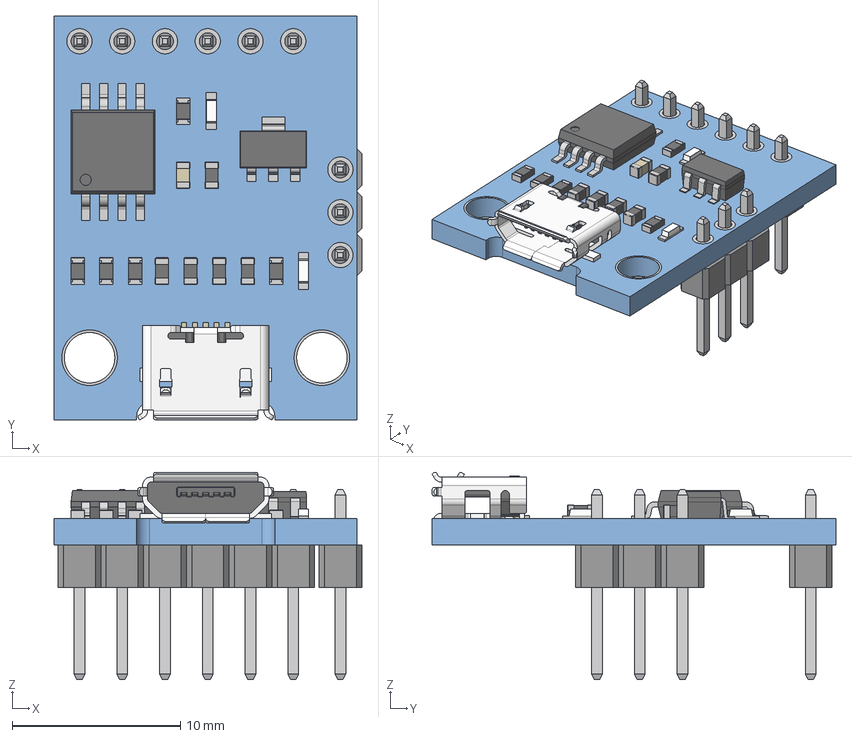
[picture p152: CAD file, 2024-08-19]
Modelos3D/Std_parts/Digispark Attiny85/STEP/Digispark Attiny85 (with pin headers).step
18.3 x 24.0 x 12.3 mm
Pads B
Pads F
Plastic
Pins
Micro USB
