JaimeBravoAlgaba/Helios_SoftRobot/Modelos3D/Std_parts/tower-pro-sg90-micro-servo-2.snapshot.8/SLD/microservoArm.SLDPRT

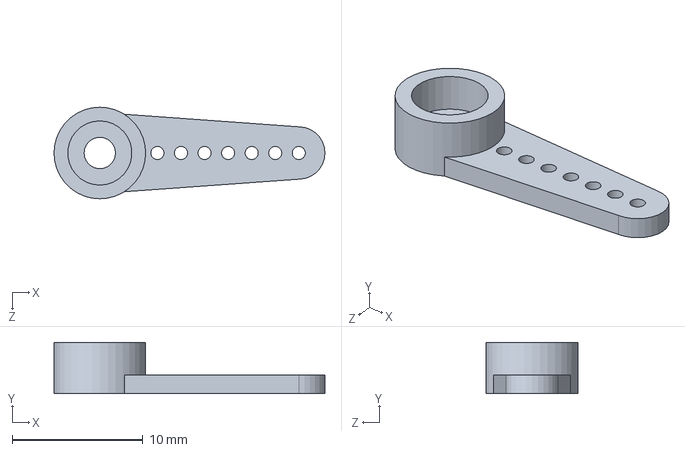
[picture p153: CAD file, 2024-08-19]
Modelos3D/Std_parts/tower-pro-sg90-micro-servo-2.snapshot.8/SLD/microservoArm.SLDPRT
20.7 x 3.90 x 7.00 mm
