JaimeBravoAlgaba/Helios_SoftRobot/Modelos3D/Actuador/STL/CE3PRO_bastidor.3mf

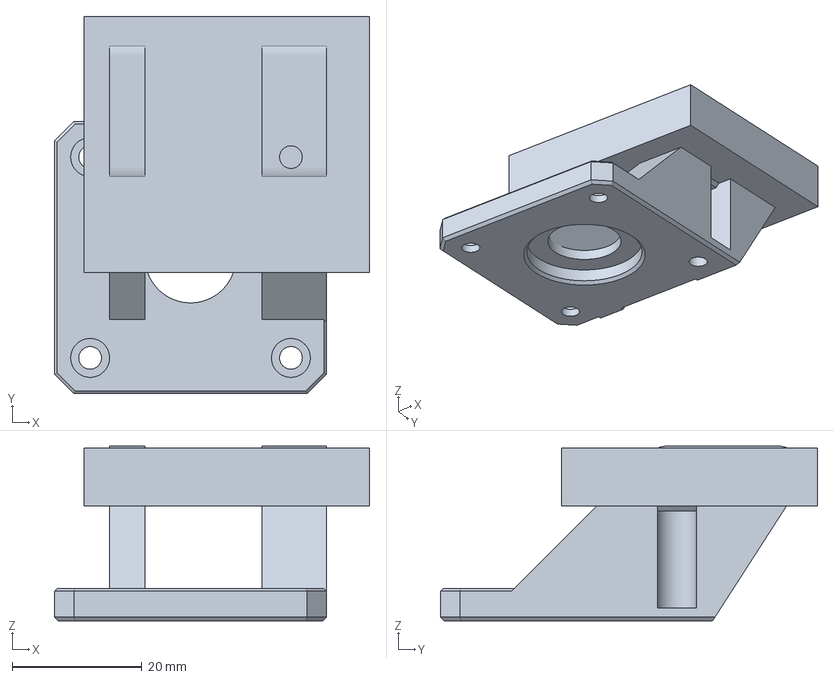
[picture p154: CAD file, 2024-08-04]
Modelos3D/Actuador/STL/CE3PRO_bastidor.3mf
48.6 x 58.2 x 27.0 mm
