JaimeBravoAlgaba/Helios_SoftRobot/Modelos3D/Modulo_IMU/STEP/Helios_IMU_F.step

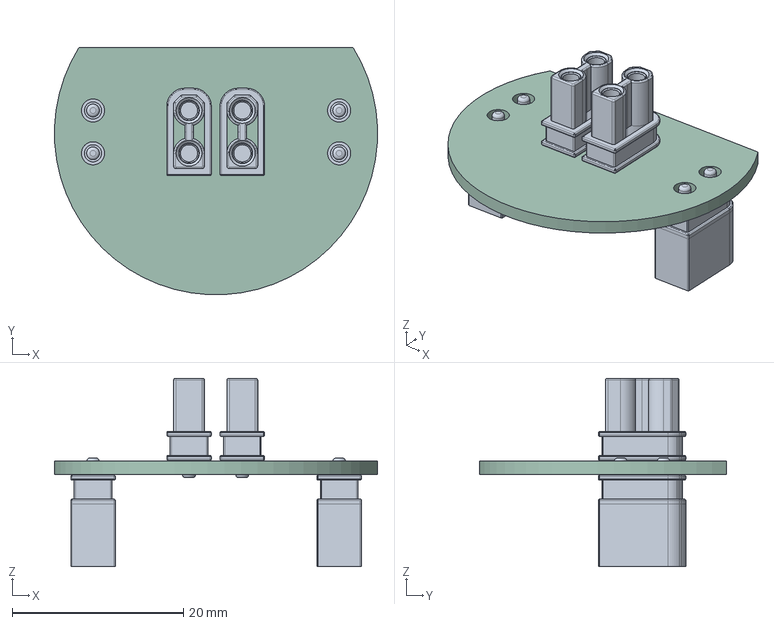
[picture p155: CAD file, 2024-08-19]
Modelos3D/Modulo_IMU/STEP/Helios_IMU_F.step
37.7 x 28.9 x 22.0 mm
ASSEMBLY x 4
Helios_IMU_F_PCB
