JaimeBravoAlgaba/Helios_SoftRobot/Modelos3D/Std_parts/Digispark Attiny85/STEP/Digispark Attiny85.step

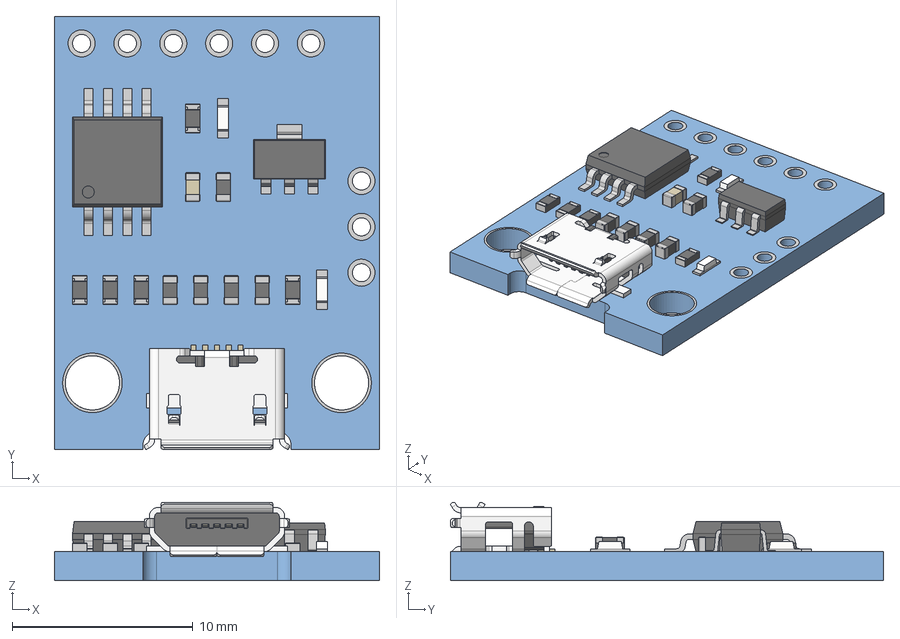
[picture p156: CAD file, 2024-08-19]
Modelos3D/Std_parts/Digispark Attiny85/STEP/Digispark Attiny85.step
18.0 x 24.0 x 4.33 mm
Pads B
Pads F
Micro USB
