JaimeBravoAlgaba/Helios_SoftRobot/Modelos3D/Std_parts/tower-pro-sg90-micro-servo-2.snapshot.8/SLD/microservoSG90.SLDPRT

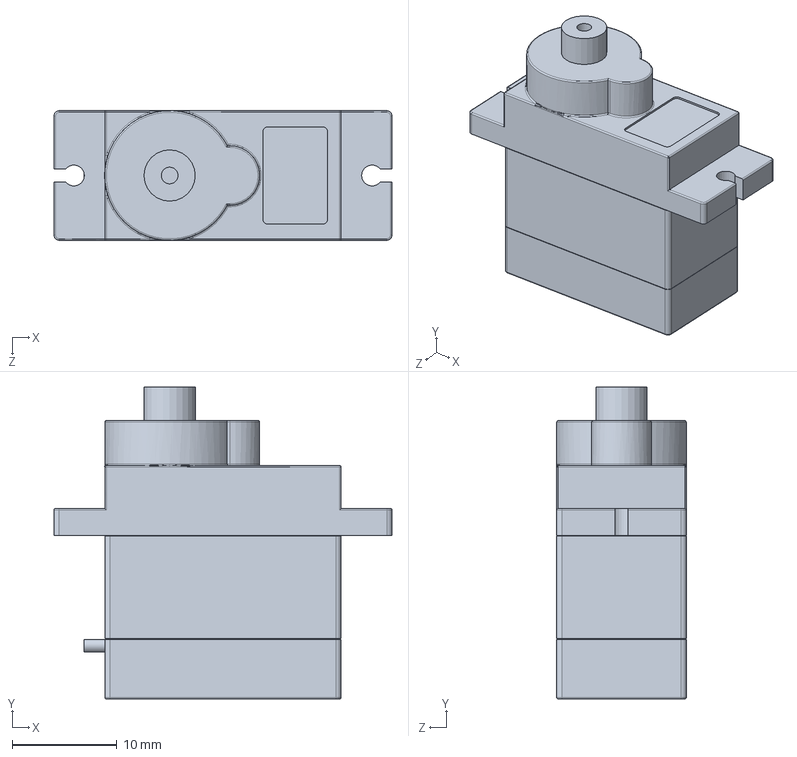
[picture p157: CAD file, 2024-08-19]
Modelos3D/Std_parts/tower-pro-sg90-micro-servo-2.snapshot.8/SLD/microservoSG90.SLDPRT
32.3 x 29.8 x 12.4 mm
