JaimeBravoAlgaba/Helios_SoftRobot/(list of files, cad)

Other CAD files:
Modelos3D/Std_parts/tower-pro-sg90-micro-servo-2.snapshot.8/STEP/microservoAssembly.STEP
Modelos3D/BancoMotores/SoporteMotores.dxf
