JaimeBravoAlgaba/Helios_SoftRobot/Media/Imágenes/Sensor/HeliosModule_montaje.jpg

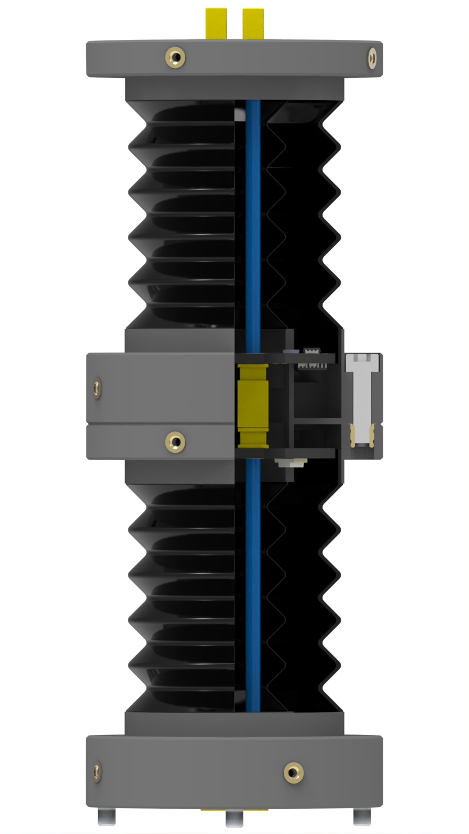
Media/Imágenes/Sensor/HeliosModule_montaje.jpg
