JaimeBravoAlgaba/Helios_SoftRobot/Media/Imágenes/Sensor/Montaje/Paso1.jpg

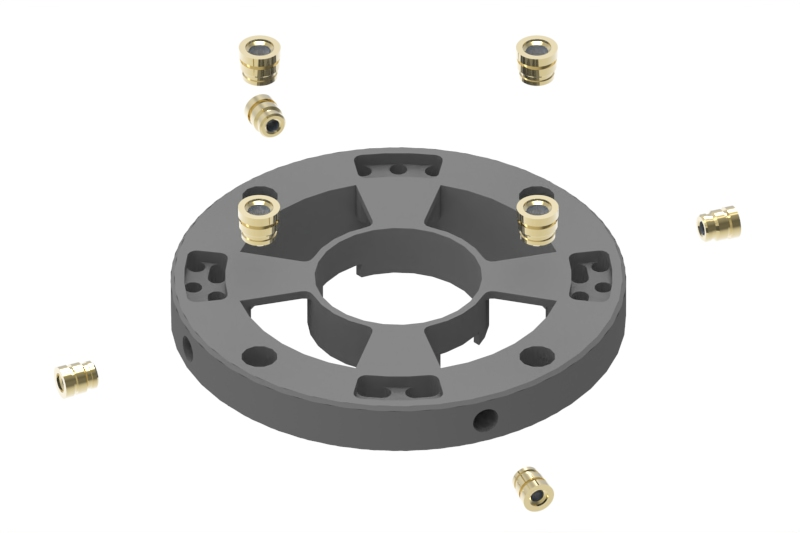
Media/Imágenes/Sensor/Montaje/Paso1.jpg
