JaimeBravoAlgaba/Helios_SoftRobot/Media/Imágenes/Sensor/Montaje/Paso2.jpg

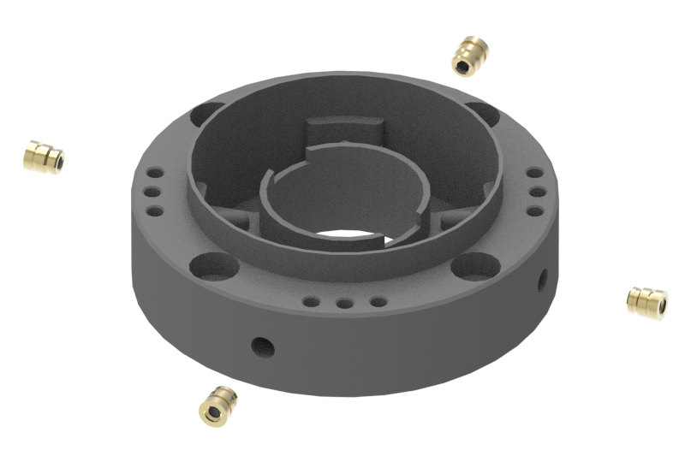
Media/Imágenes/Sensor/Montaje/Paso2.jpg
