JaimeBravoAlgaba/Helios_SoftRobot/Media/Imágenes/Sensor/Montaje/Paso3.jpg

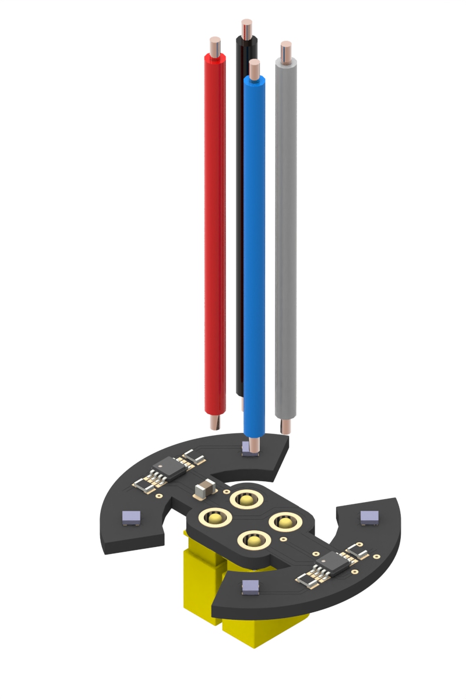
Media/Imágenes/Sensor/Montaje/Paso3.jpg
