JaimeBravoAlgaba/Helios_SoftRobot/Media/Imágenes/Sensor/Montaje/Paso5_A.jpg

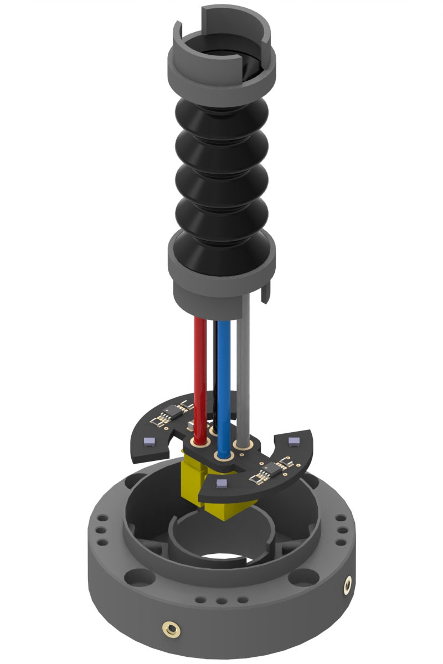
Media/Imágenes/Sensor/Montaje/Paso5_A.jpg
