JaimeBravoAlgaba/Helios_SoftRobot/Media/Imágenes/Sensor/Montaje/Paso5_B.jpg

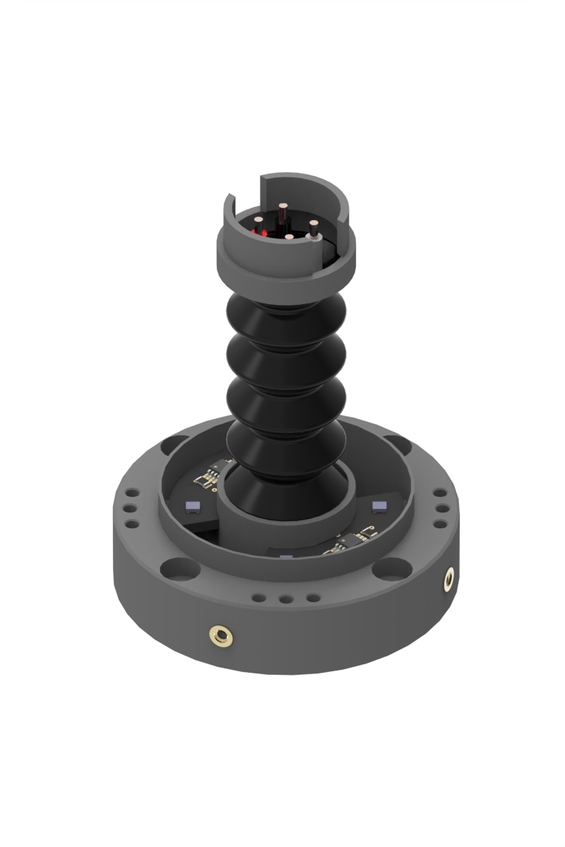
Media/Imágenes/Sensor/Montaje/Paso5_B.jpg
