JaimeBravoAlgaba/Helios_SoftRobot/Media/Imágenes/Sensor/Montaje/Paso6_A.jpg

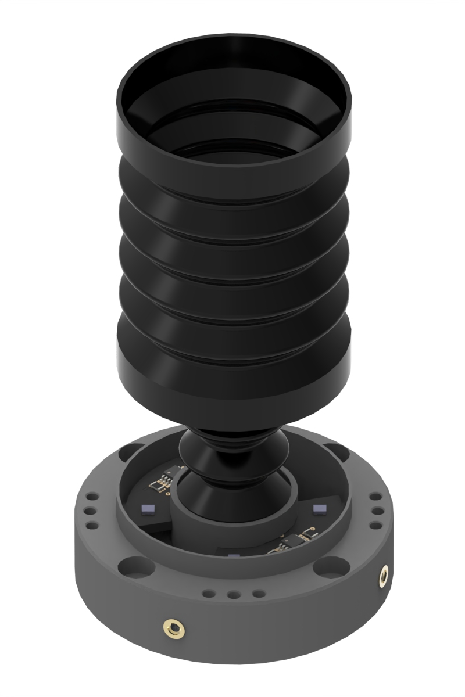
Media/Imágenes/Sensor/Montaje/Paso6_A.jpg
