JaimeBravoAlgaba/Helios_SoftRobot/Media/Imágenes/Sensor/Montaje/Paso6_B.jpg

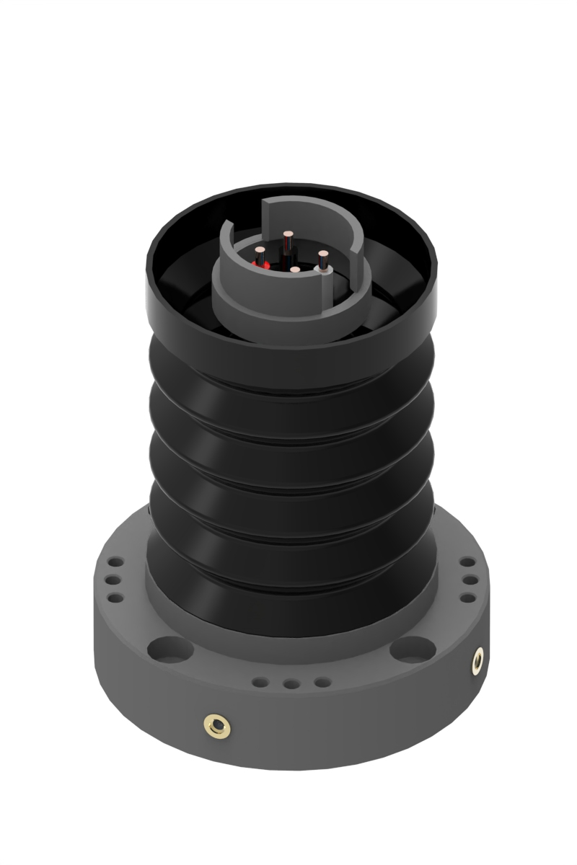
Media/Imágenes/Sensor/Montaje/Paso6_B.jpg
