JaimeBravoAlgaba/Helios_SoftRobot/Media/Imágenes/Sensor/Montaje/Paso7_A.jpg

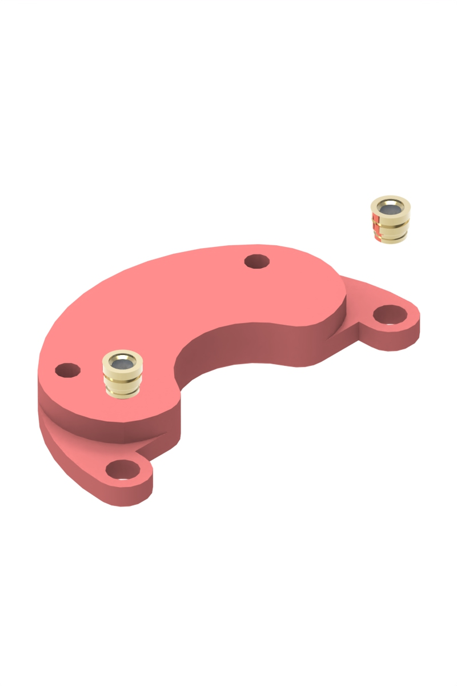
Media/Imágenes/Sensor/Montaje/Paso7_A.jpg
