JaimeBravoAlgaba/Helios_SoftRobot/Media/Imágenes/Sensor/Montaje/Paso7_B.jpg

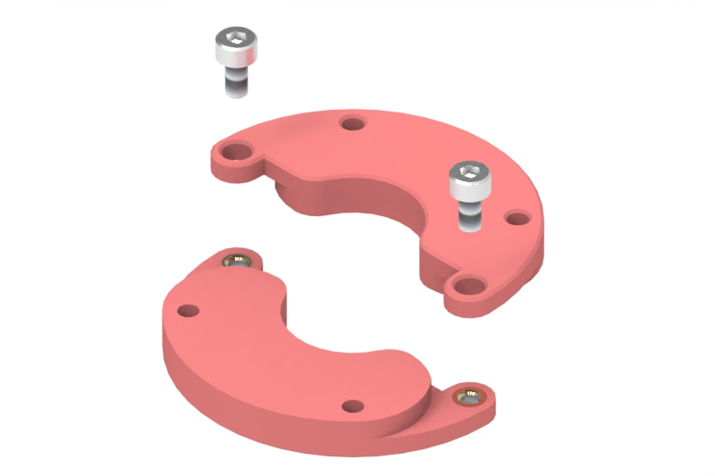
Media/Imágenes/Sensor/Montaje/Paso7_B.jpg
