JaimeBravoAlgaba/Helios_SoftRobot/Media/Imágenes/Sensor/Montaje/Paso8_A.jpg

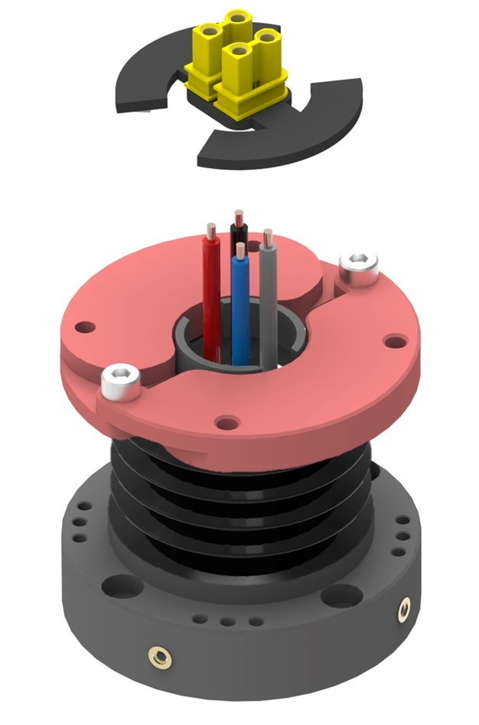
Media/Imágenes/Sensor/Montaje/Paso8_A.jpg
