JaimeBravoAlgaba/Helios_SoftRobot/Media/Imágenes/Sensor/Montaje/Paso8_C.jpg

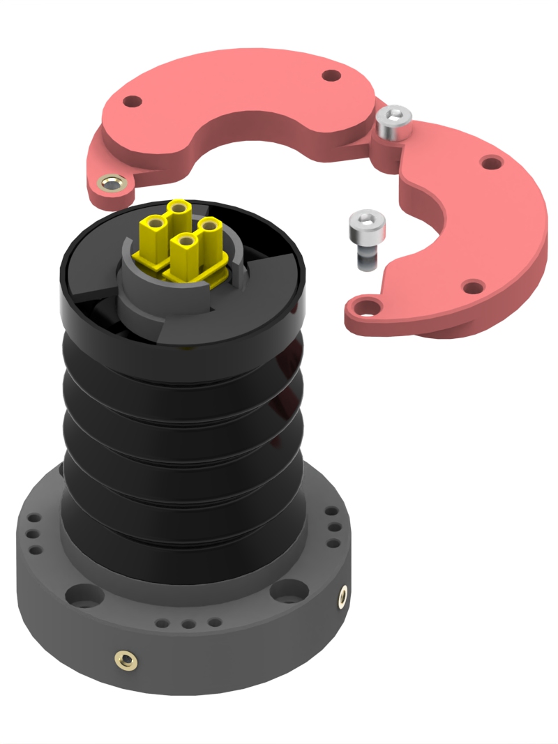
Media/Imágenes/Sensor/Montaje/Paso8_C.jpg
