JaimeBravoAlgaba/Helios_SoftRobot/Media/Imágenes/Sensor/Montaje/Paso9.jpg

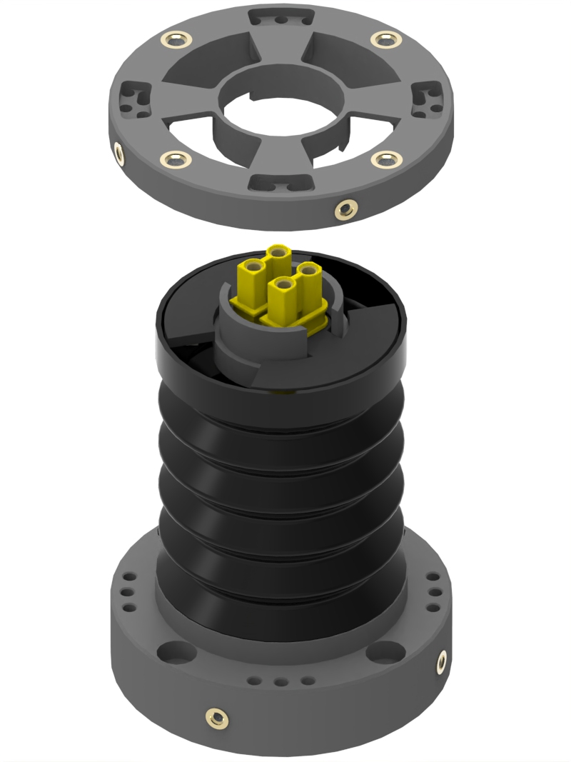
Media/Imágenes/Sensor/Montaje/Paso9.jpg
