JaimeBravoAlgaba/Helios_SoftRobot/Media/Imágenes/Sensor/WaveGuides/difracciónInterna.jpg

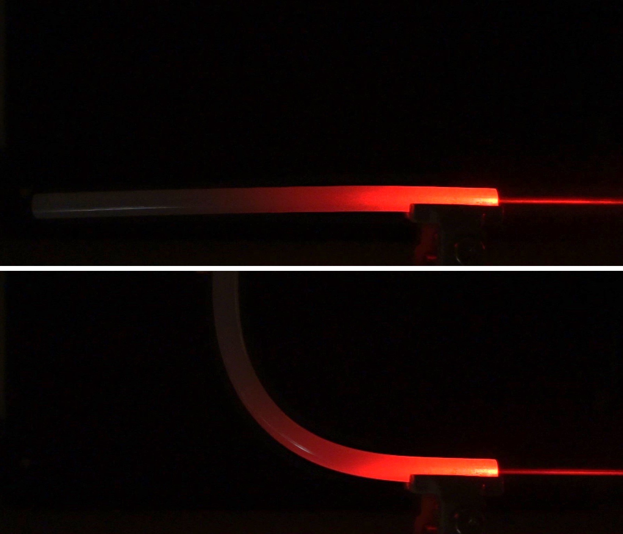
Media/Imágenes/Sensor/WaveGuides/difracciónInterna.jpg
