JaimeBravoAlgaba/Helios_SoftRobot/Media/Imágenes/Sensor/WaveGuides/DSC03746.JPG

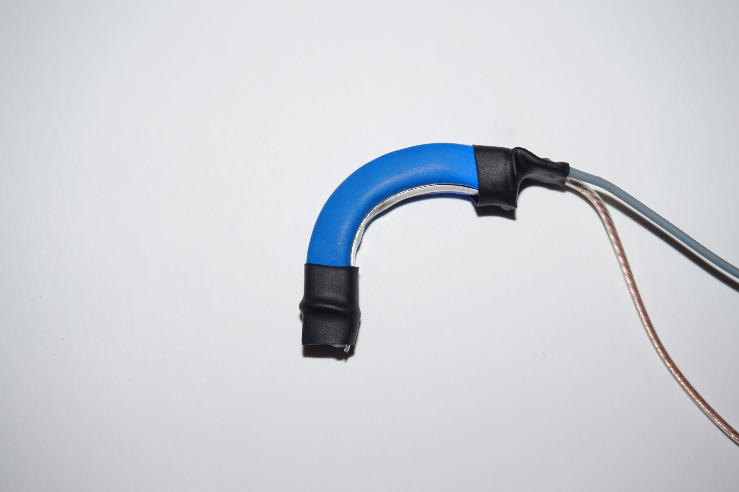
Media/Imágenes/Sensor/WaveGuides/DSC03746.JPG
