JaimeBravoAlgaba/Helios_SoftRobot/Media/Imágenes/Sensor/WaveGuides/DSC03751.JPG

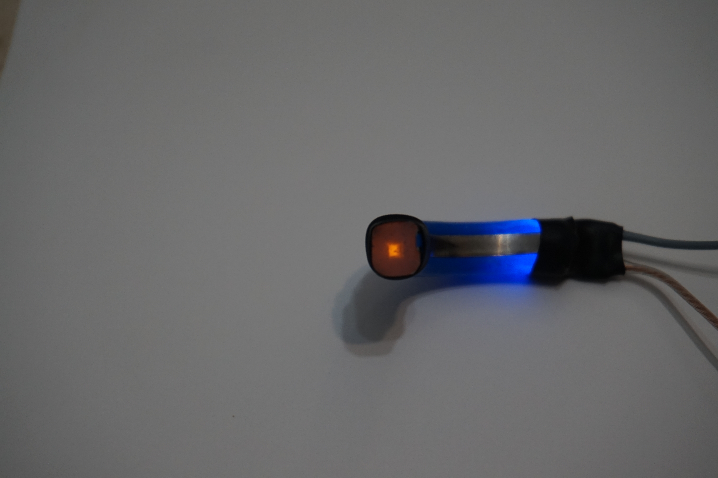
Media/Imágenes/Sensor/WaveGuides/DSC03751.JPG
