JaimeBravoAlgaba/Helios_SoftRobot/Media/Imágenes/Sensor/WaveGuides/DSC03753.JPG

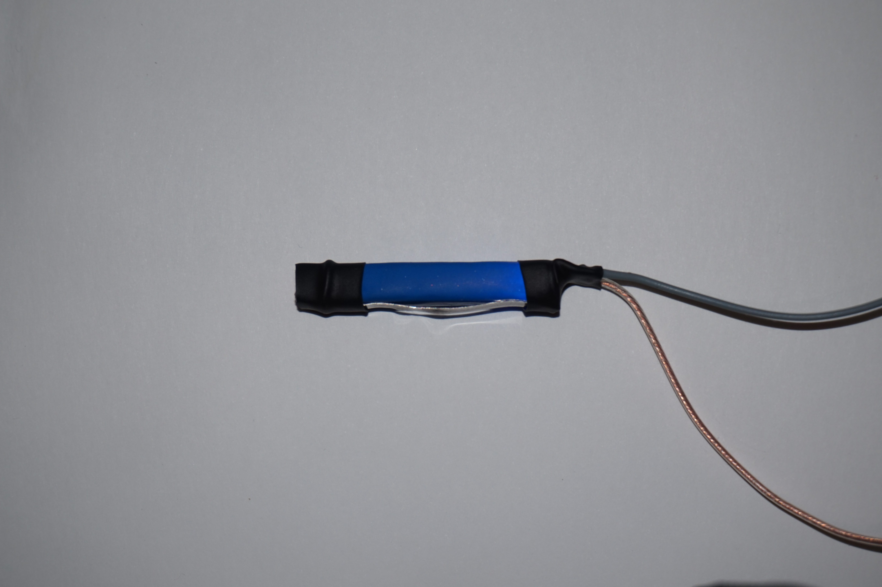
Media/Imágenes/Sensor/WaveGuides/DSC03753.JPG
