JaimeBravoAlgaba/Helios_SoftRobot/Media/Imágenes/Sensor/WaveGuides/DSC03754.JPG

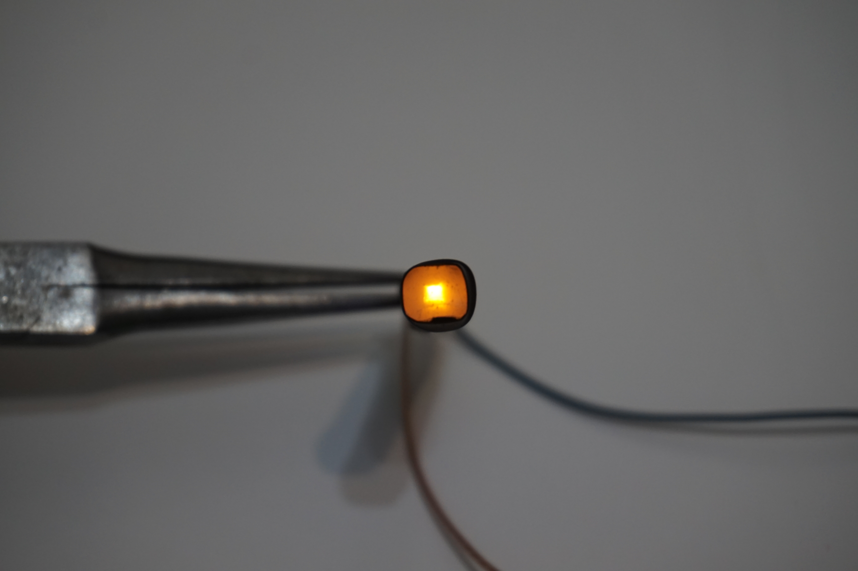
Media/Imágenes/Sensor/WaveGuides/DSC03754.JPG
