JaimeBravoAlgaba/Helios_SoftRobot/Media/Imágenes/Sensor/WaveGuides/DSC03756.JPG

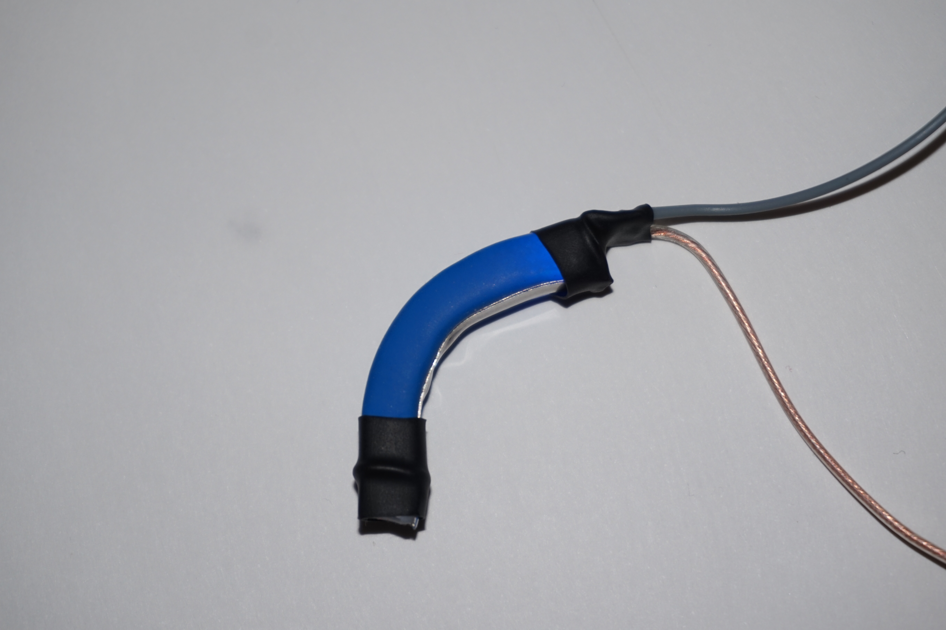
Media/Imágenes/Sensor/WaveGuides/DSC03756.JPG
