JaimeBravoAlgaba/Helios_SoftRobot/Media/Imágenes/Sensor/WaveGuides/DSC03758.JPG

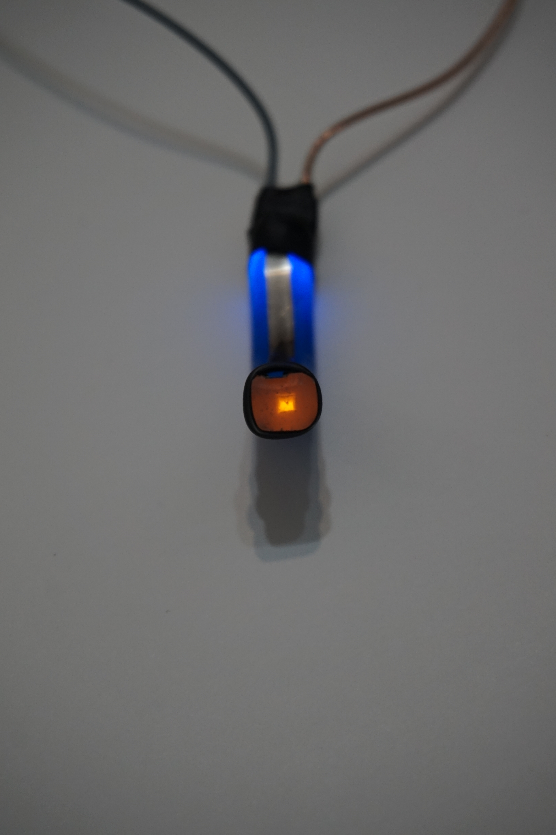
Media/Imágenes/Sensor/WaveGuides/DSC03758.JPG
