JaimeBravoAlgaba/Helios_SoftRobot/Media/Imágenes/Sensor/WaveGuides/DSC03760.JPG

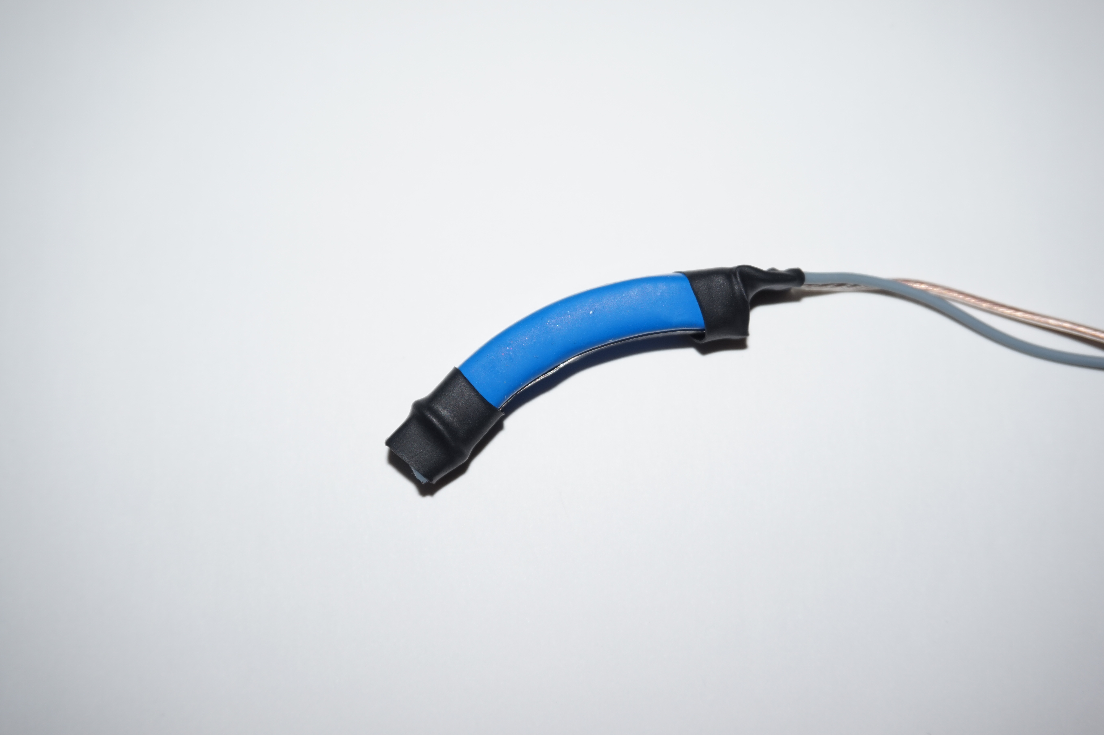
Media/Imágenes/Sensor/WaveGuides/DSC03760.JPG
