JaimeBravoAlgaba/Helios_SoftRobot/Media/Imágenes/Sensor/WaveGuides/DSC03763.JPG

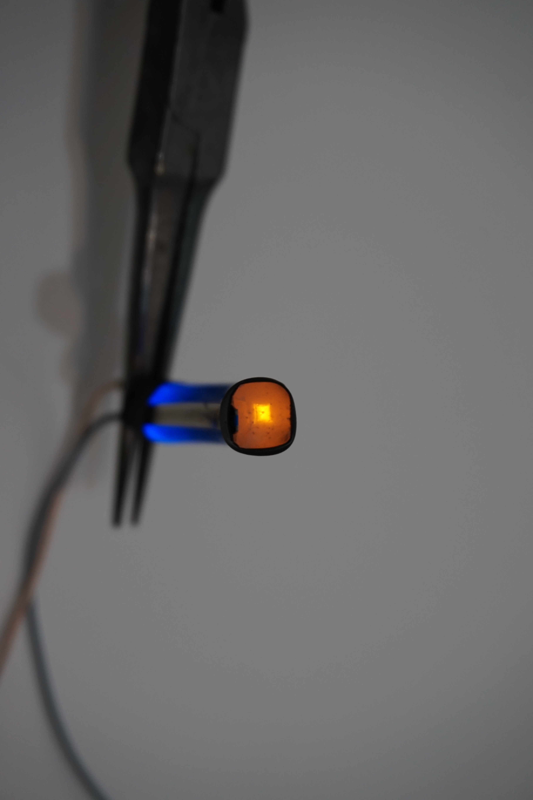
Media/Imágenes/Sensor/WaveGuides/DSC03763.JPG
