JaimeBravoAlgaba/Helios_SoftRobot/Media/Imágenes/Sensor/WaveGuides/DSC03765.JPG

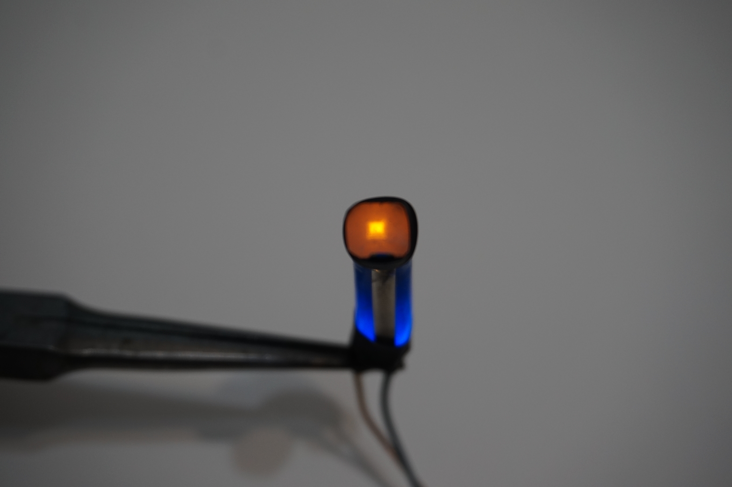
Media/Imágenes/Sensor/WaveGuides/DSC03765.JPG
