JaimeBravoAlgaba/Helios_SoftRobot/Media/Imágenes/Sensor/WaveGuides/DSC03766.JPG

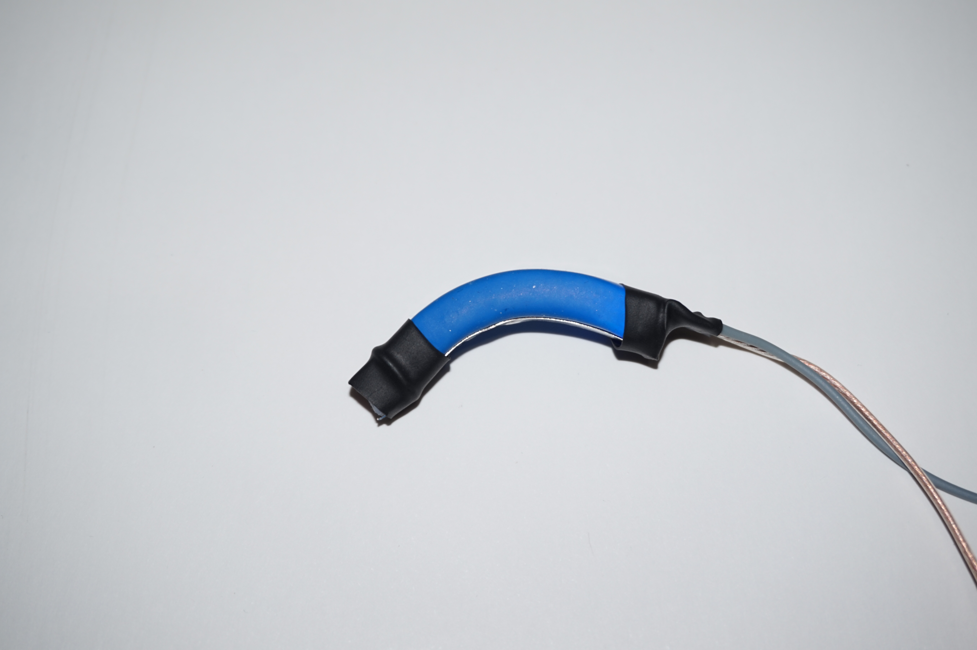
Media/Imágenes/Sensor/WaveGuides/DSC03766.JPG
