JaimeBravoAlgaba/Helios_SoftRobot/Media/Imágenes/Sensor/WaveGuides/DSC03767.JPG

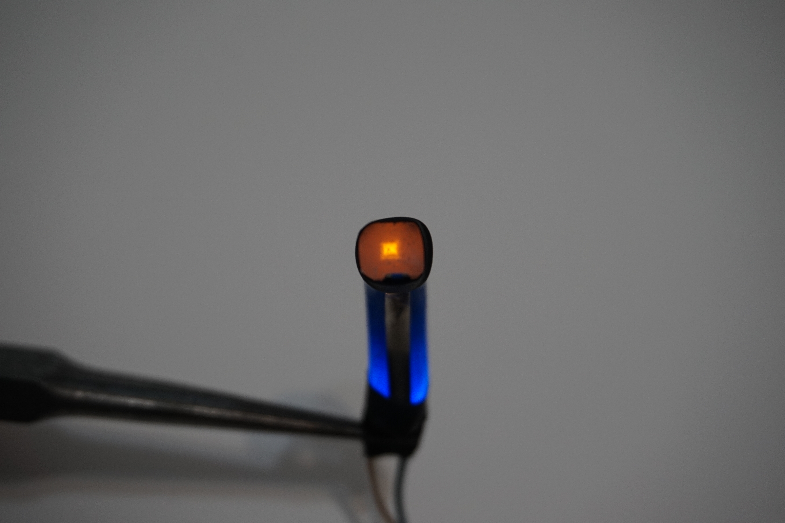
Media/Imágenes/Sensor/WaveGuides/DSC03767.JPG
