JaimeBravoAlgaba/Helios_SoftRobot/Media/Imágenes/Sensor/WaveGuides/MatlabAnalysis/Cladding_0.png

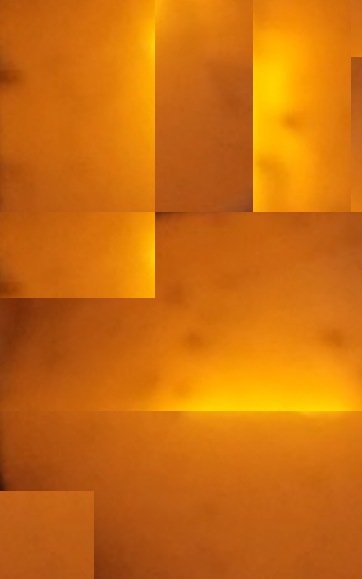
Media/Imágenes/Sensor/WaveGuides/MatlabAnalysis/Cladding_0.png
