JaimeBravoAlgaba/Helios_SoftRobot/Media/Imágenes/Sensor/WaveGuides/MatlabAnalysis/Cladding_30.png

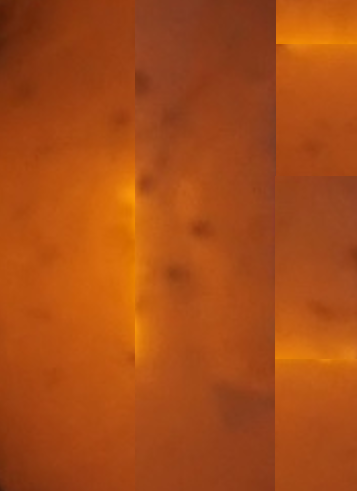
Media/Imágenes/Sensor/WaveGuides/MatlabAnalysis/Cladding_30.png
