JaimeBravoAlgaba/Helios_SoftRobot/Media/Imágenes/Sensor/WaveGuides/MatlabAnalysis/Cladding_45.png

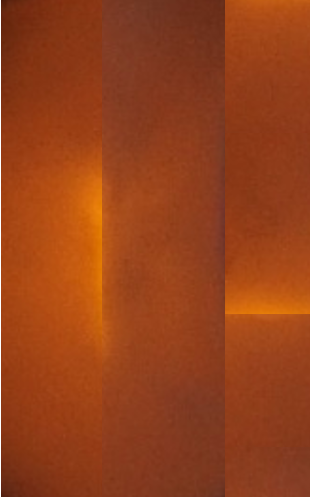
Media/Imágenes/Sensor/WaveGuides/MatlabAnalysis/Cladding_45.png
