JaimeBravoAlgaba/Helios_SoftRobot/Media/Imágenes/Sensor/WaveGuides/MatlabAnalysis/Cladding_90.png

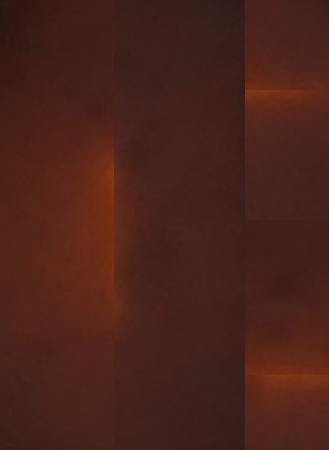
Media/Imágenes/Sensor/WaveGuides/MatlabAnalysis/Cladding_90.png
