JaimeBravoAlgaba/Helios_SoftRobot/Media/Imágenes/Sensor/WaveGuides/MatlabAnalysis/Core_0.png

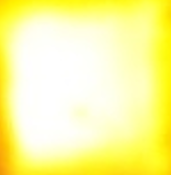
Media/Imágenes/Sensor/WaveGuides/MatlabAnalysis/Core_0.png
