JaimeBravoAlgaba/Helios_SoftRobot/Media/Imágenes/Sensor/WaveGuides/MatlabAnalysis/Core_30.png

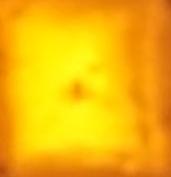
Media/Imágenes/Sensor/WaveGuides/MatlabAnalysis/Core_30.png
