JaimeBravoAlgaba/Helios_SoftRobot/Media/Imágenes/Sensor/WaveGuides/MatlabAnalysis/Core_60.png

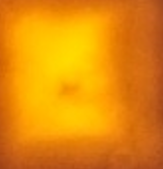
Media/Imágenes/Sensor/WaveGuides/MatlabAnalysis/Core_60.png
