JaimeBravoAlgaba/Helios_SoftRobot/Media/Imágenes/Sensor/WaveGuides/MatlabAnalysis/Core_90.png

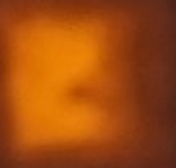
Media/Imágenes/Sensor/WaveGuides/MatlabAnalysis/Core_90.png
