JaimeBravoAlgaba/Helios_SoftRobot/Media/Imágenes/Sensor/WaveGuides/ProbetaWaveGuides.png

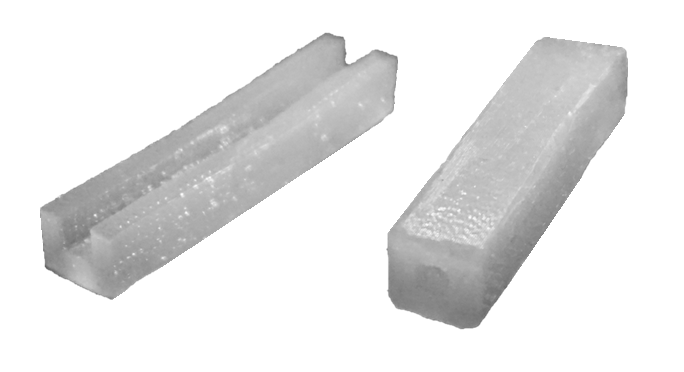
Media/Imágenes/Sensor/WaveGuides/ProbetaWaveGuides.png
