JaimeBravoAlgaba/Helios_SoftRobot/Media/Imágenes/Sensor/WaveGuides/WaveGuides_bendingTest - copia.png

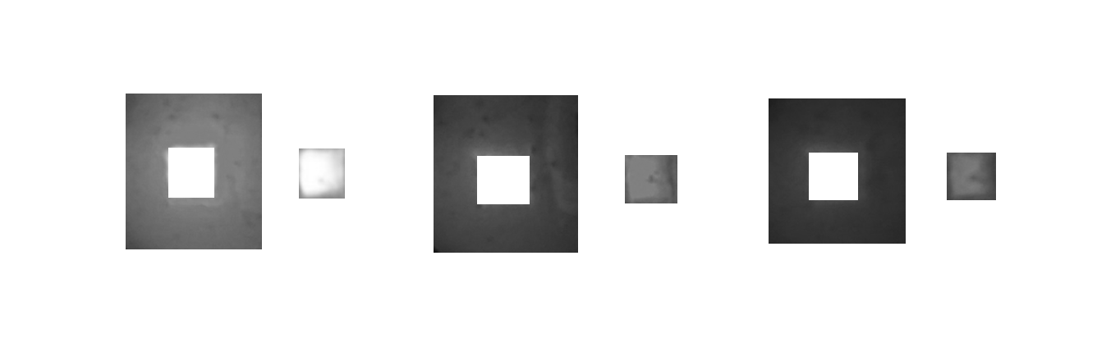
Media/Imágenes/Sensor/WaveGuides/WaveGuides_bendingTest - copia.png
