JaimeBravoAlgaba/Helios_SoftRobot/Modelos3D/BancoMotores/MontajeRobot.jpg

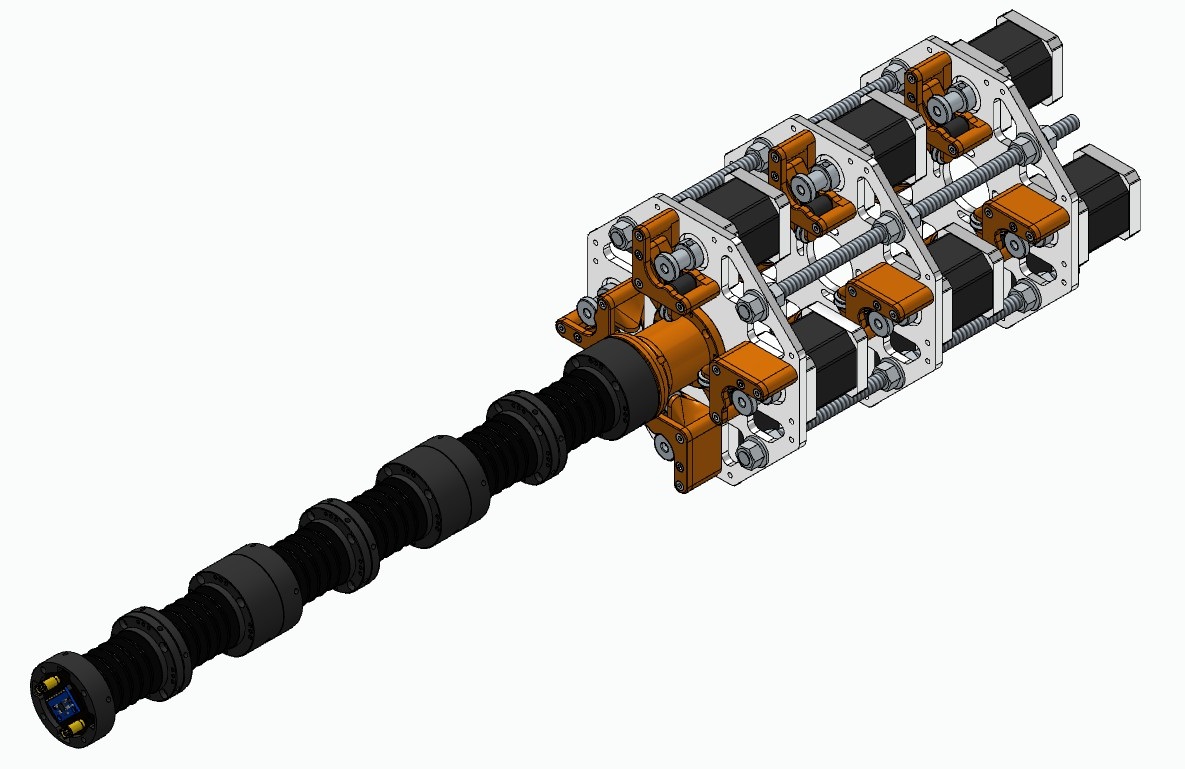
Modelos3D/BancoMotores/MontajeRobot.jpg
