JaimeBravoAlgaba/Helios_SoftRobot/Modelos3D/BancoMotores/MontajeRobot_derecha.jpg

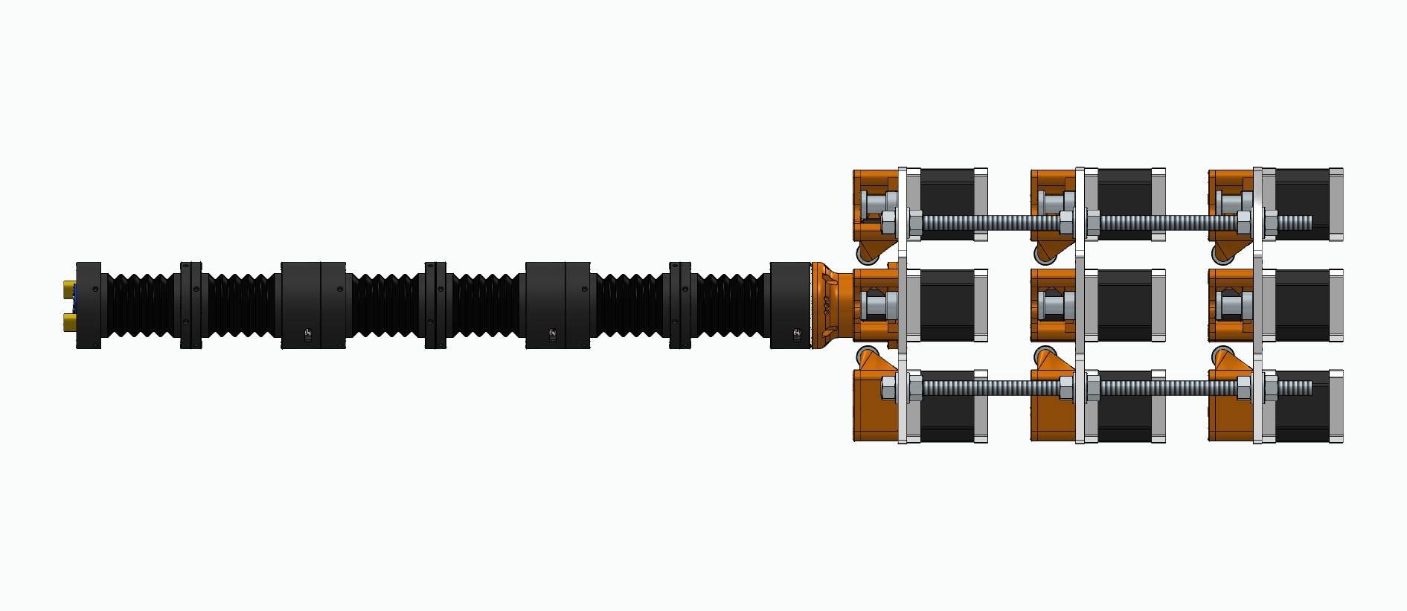
Modelos3D/BancoMotores/MontajeRobot_derecha.jpg
