JaimeBravoAlgaba/Helios_SoftRobot/Código/ModuleCharacterization/abs_error_phi.csv

abs_error_phi
0.26116795148977
0.04501494245398607
0.0574410258210063
0.020018695222546956
0.016932466154500503
0.013030634793675722
0.034537307033584375
0.15690723569580212
0.320014201653114
0.18757705869114538
0.09440884280808515
0.0368035878317714
0.02983785086261359
0.05580359213176056
0.0020724627015749064
0.009271791450760958
0.030697243953760056
0.019202026811451667
0.4846356430390659
0.24310086543101272
0.3646036226921556
0.20089068637257523
0.3063101115709264
0.0775011550070312
0.11384108105206836
0.1928912681536869
0.2883201347980088
0.1947866617707802
0.7724826445851589
0.21229730627382004
0.9380536972626659
0.37003076322835593
0.20886434234514173
0.03226619005276632
0.005806132350358872
0.006876534570471549
0.11219196843804813
0.2676178523780841
0.6903497831046854
0.19649137351556645
0.8923990679322125
1.8585366202787892
0.851094795704527
0.2869960545398129
0.2340101838150428
0.36409824238420363
0.619052754296189
2.541629903082378
1.4491087320107696
0.2106107012452978
0.7238617575863464
0.7805232755565461
0.26711418330450654
0.09001383140166608
0.062076002052634305
0.06536299224974185
0.1192687490245623
0.9140478307294937
0.937242972895965
0.279385629416411
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
