JaimeBravoAlgaba/Helios_SoftRobot/Media/Imágenes/Pruebas/POSE 1/Screenshot from 2024-09-03 19-26-38.png

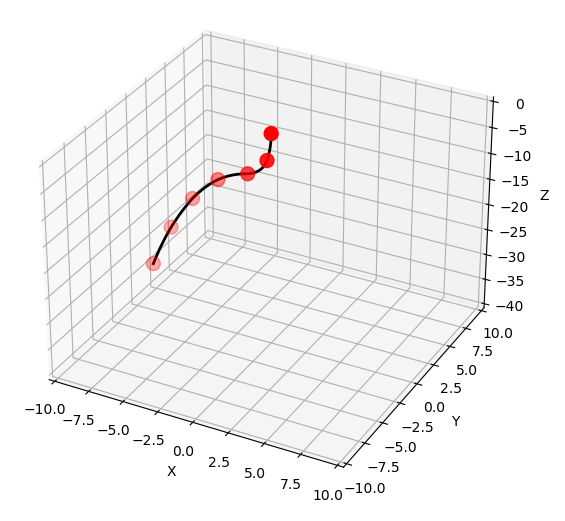
Media/Imágenes/Pruebas/POSE 1/Screenshot from 2024-09-03 19-26-38.png
