JaimeBravoAlgaba/Helios_SoftRobot/Media/Imágenes/Pruebas/POSE 2/Screenshot from 2024-09-03 19-58-44.png

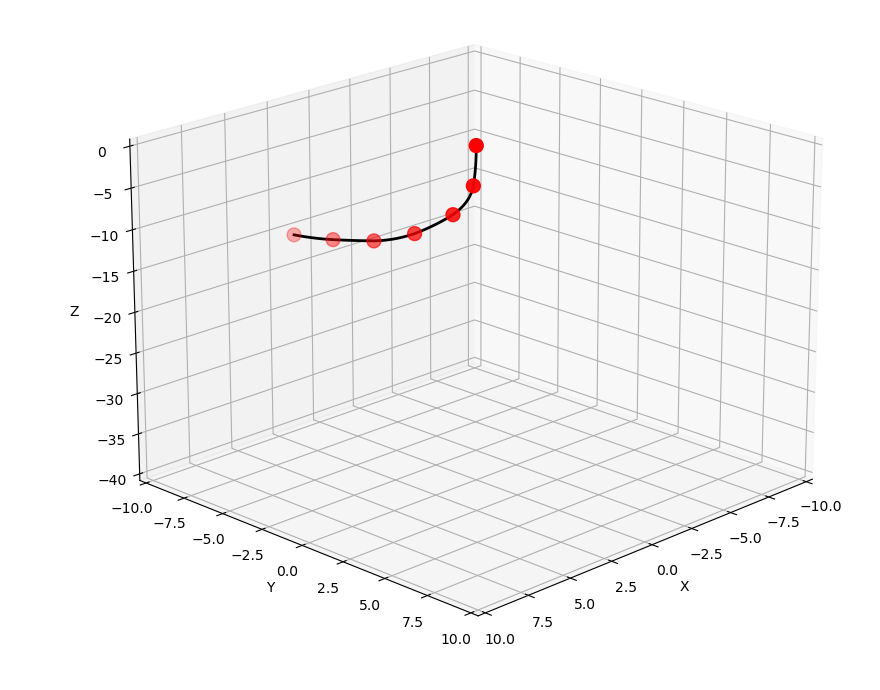
Media/Imágenes/Pruebas/POSE 2/Screenshot from 2024-09-03 19-58-44.png
