JaimeBravoAlgaba/Helios_SoftRobot/Media/Imágenes/Pruebas/POSE 2/Screenshot from 2024-09-03 20-08-30.png

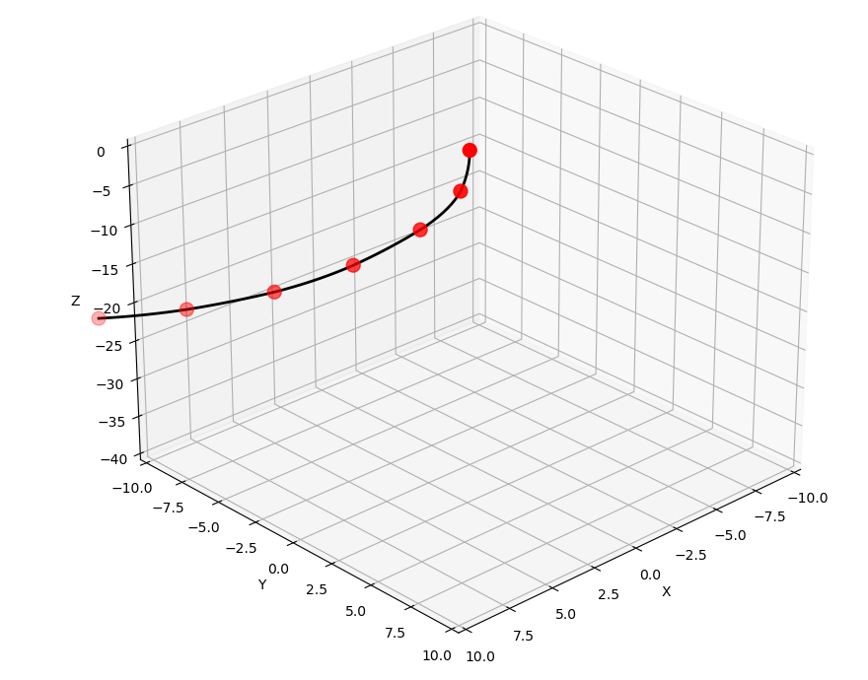
Media/Imágenes/Pruebas/POSE 2/Screenshot from 2024-09-03 20-08-30.png
