JaimeBravoAlgaba/Helios_SoftRobot/Media/Imágenes/Pruebas/POSE 3/Screenshot from 2024-09-03 20-12-48.png

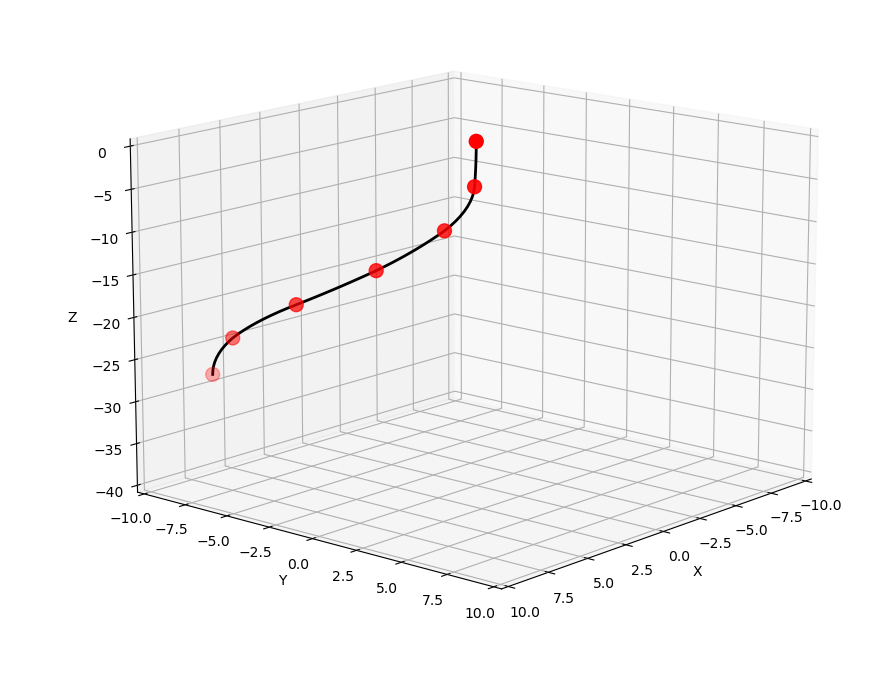
Media/Imágenes/Pruebas/POSE 3/Screenshot from 2024-09-03 20-12-48.png
