JaimeBravoAlgaba/Helios_SoftRobot/Media/Imágenes/Sensor/WaveGuides/results.png

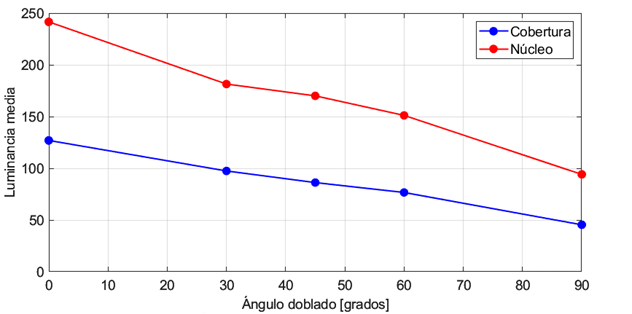
Media/Imágenes/Sensor/WaveGuides/results.png
