JaimeBravoAlgaba/Helios_SoftRobot/Electrónica/Helios/Helios_PCB/Helios_IMU_M/Helios_IMU_M.kicad_pcb

## KiCad design Electrónica/Helios/Helios_PCB/Helios_IMU_M/Helios_IMU_M.kicad_pcb (2024-08-19)

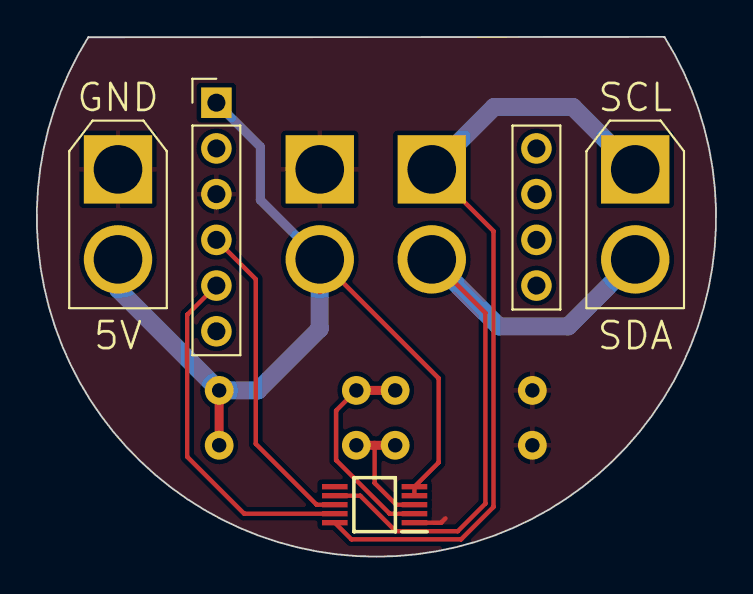
[picture p213: board Helios_IMU_M.kicad_pcb from above]

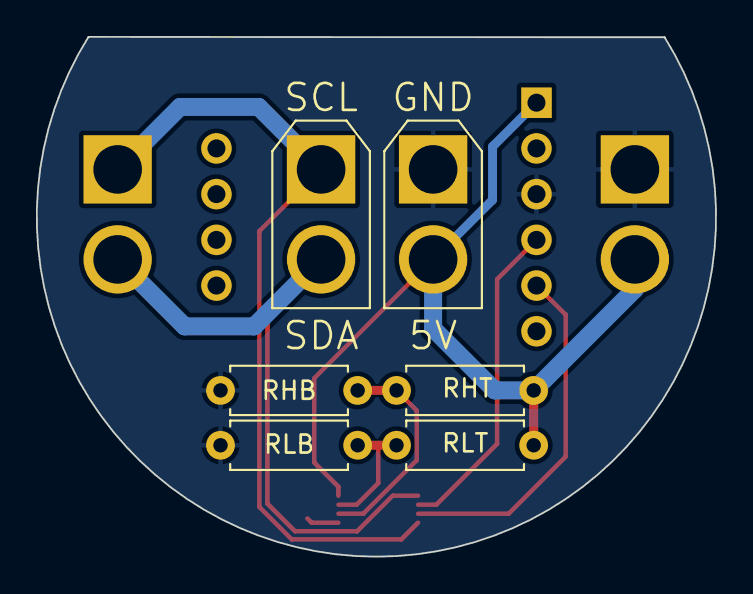
[picture p214: board Helios_IMU_M.kicad_pcb from below]

Board: 2 copper layers, 37.7 x 28.9 mm, 10 parts (6 on the bottom side), 8 nets.

Parts:
IMU1: BNO_055
J1, J2, J3, J4: Conn_01x02_Pin; XT30U-M_1x02_P5.0mm_Vertical
LTC4316: LTC4316CMS#PBF; SOP50P490X110-10N
RHB: R; R_Axial_DIN0207_L6.3mm_D2.5mm_P7.62mm_Horizontal
RHT: R; R_Axial_DIN0207_L6.3mm_D2.5mm_P7.62mm_Horizontal
RLB: R; R_Axial_DIN0207_L6.3mm_D2.5mm_P7.62mm_Horizontal
RLT: R; R_Axial_DIN0207_L6.3mm_D2.5mm_P7.62mm_Horizontal

Connections:
GND: IMU1.3 (GND), J1.1, J3.1, LTC4316.1 (GND), RHB.2, RLB.2
SCL: J2.1, J4.1, LTC4316.10 (SCLIN)
SCL_OUT: IMU1.5 (SCL), LTC4316.9 (SCLOUT)
SDA: J2.2, J4.2, LTC4316.7 (SDAIN)
SDA_OUT: IMU1.4 (SDA), LTC4316.8 (SDAOUT)
VCC: IMU1.1 (Vin), J1.2, J3.2, LTC4316.4 (VCC), LTC4316.5 (ENABLE), RHT.1, RLT.1
XORH: LTC4316.2 (XORH), RHB.1, RHT.2
XORL: LTC4316.3 (XORL), RLB.1, RLT.2
