JaimeBravoAlgaba/Helios_SoftRobot/Electrónica/Helios/Helios_PCB/Helios_IMU_F/Helios_IMU_F.kicad_pcb

## KiCad design Electrónica/Helios/Helios_PCB/Helios_IMU_F/Helios_IMU_F.kicad_pcb (2024-08-19)

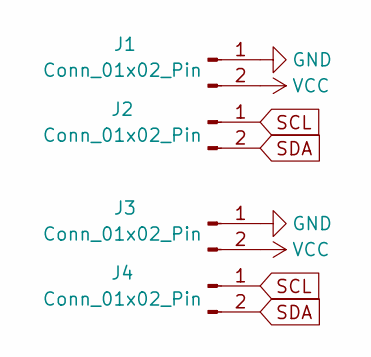
[picture p215: schematic Helios_IMU_F.kicad_sch]

Parts:
J1, J2, J3, J4: Conn_01x02_Pin; XT30U-M_1x02_P5.0mm_Vertical

Connections:
GND: J1.1, J3.1
SCL: J2.1, J4.1
SDA: J2.2, J4.2
VCC: J1.2, J3.2

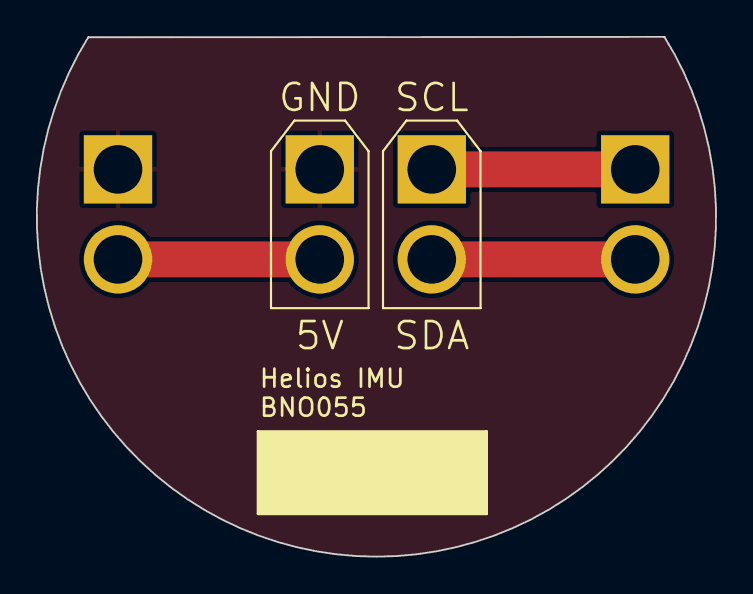
[picture p216: board Helios_IMU_F.kicad_pcb from above]

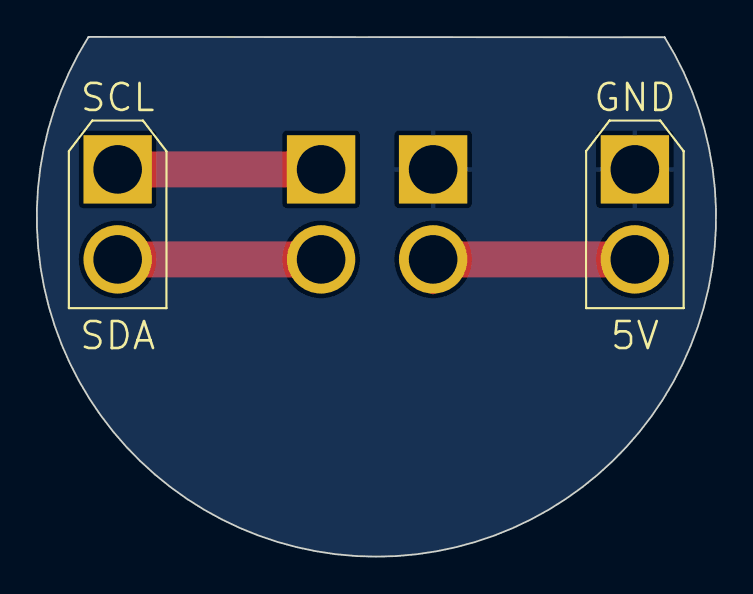
[picture p217: board Helios_IMU_F.kicad_pcb from below]

Board: 2 copper layers, 37.7 x 28.9 mm, 4 parts (2 on the bottom side), 4 nets.
