JaimeBravoAlgaba/Helios_SoftRobot/Electrónica/Helios/Helios_PCB/Helios_PCB_panel/Helios_PCB_panel.kicad_pcb

## KiCad design Electrónica/Helios/Helios_PCB/Helios_PCB_panel/Helios_PCB_panel.kicad_pcb (2024-08-13)

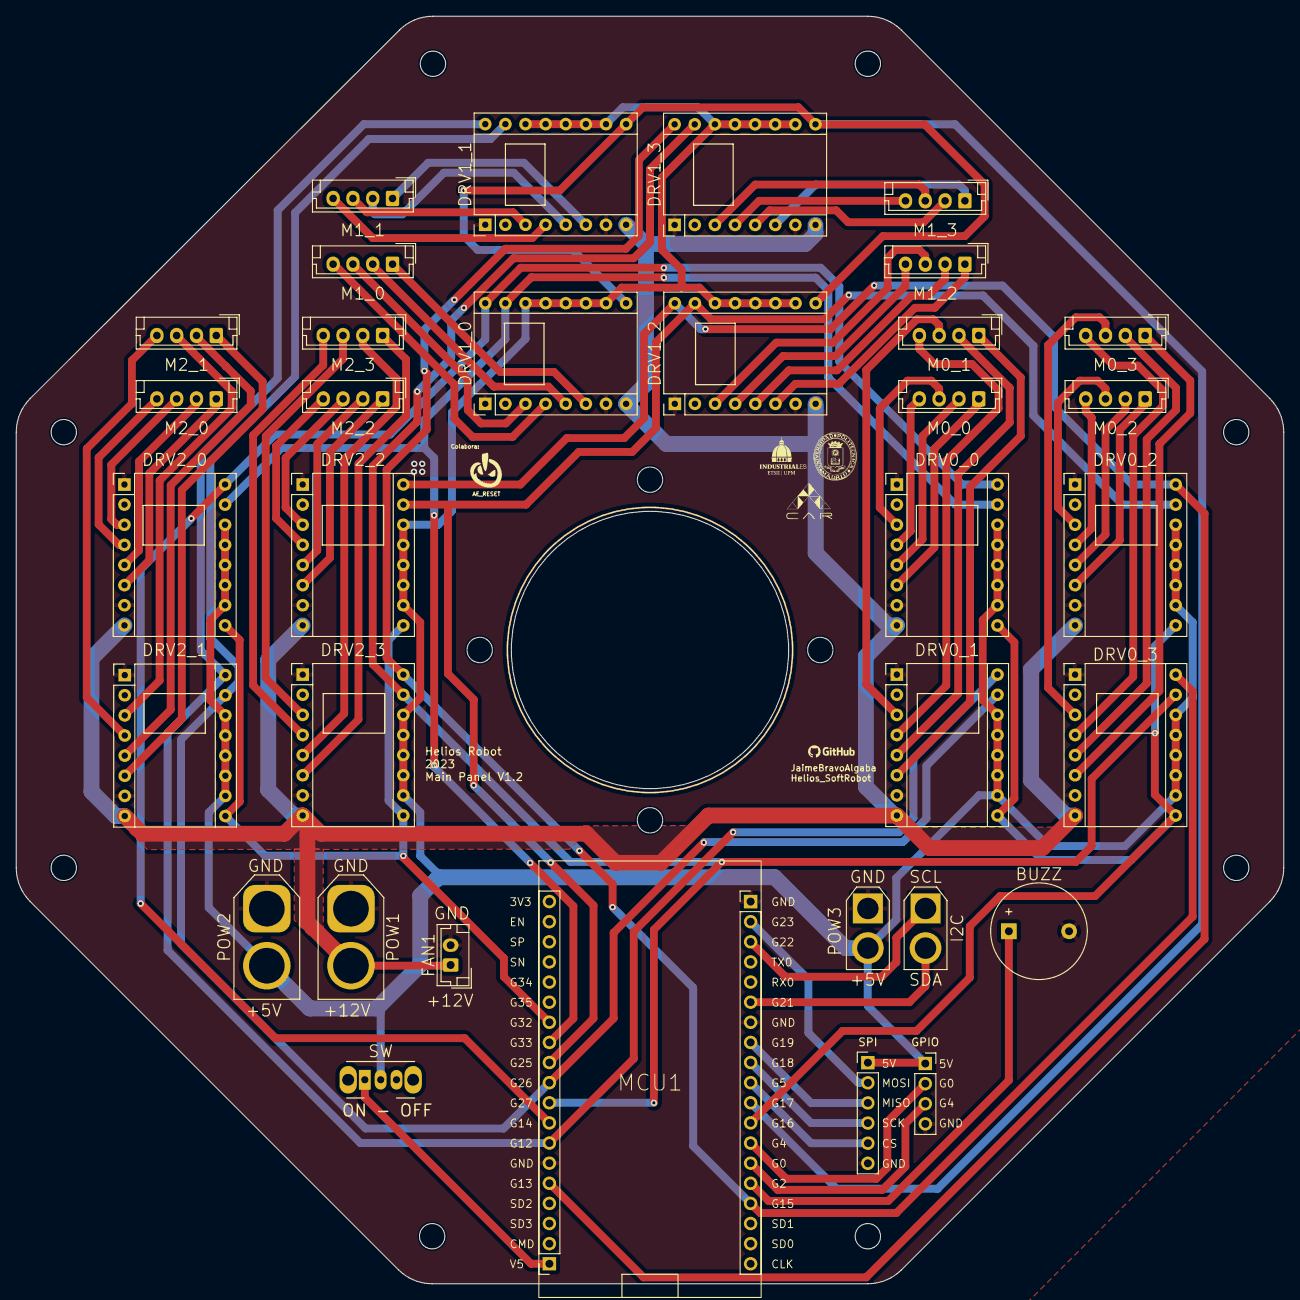
[picture p218: board Helios_PCB_panel.kicad_pcb from above]

Board: 2 copper layers, 160.0 x 160.0 mm, 46 parts (0 on the bottom side), 72 nets.

Parts:
BUZZ: Buzzer; Buzzer_12x9.5RM7.6
DRV0_0, DRV0_1, DRV0_2, DRV0_3, DRV1_0, DRV1_1, DRV1_2, DRV1_3, DRV2_0, DRV2_1, DRV2_2, DRV2_3: Pololu_Breakout_DRV8825; Pololu_Breakout-16_15.2x20.3mm
FAN1: 12VDC; JST_EH_B2B-EH-A_1x02_P2.50mm_Vertical
GPIO: Conn_01x04_Pin; PinSocket_1x04_P2.54mm_Vertical
H1, H2, H3, H4, H5, H6, H7, H8, H9, H10, H11, H12: MountingHole; MountingHole_3.2mm_M3
I2C: I2C1; XT30U-F_1x02_P5.0mm_Vertical
M0_0, M0_1, M0_2, M0_3, M1_0, M1_1, M1_2, M1_3, M2_0, M2_1, M2_2, M2_3: Conn_01x04_Pin; JST_EH_B4B-EH-A_1x04_P2.50mm_Vertical
MCU1: NodeMCU
POW1: 12VDC; XT60-M_1x02_P7.20mm_Vertical
POW2: 5VDC; XT60-M_1x02_P7.20mm_Vertical
POW3: 5VDC; XT30U-F_1x02_P5.0mm_Vertical
SPI: Conn_01x06_Pin; PinHeader_1x06_P2.54mm_Vertical
SW: SW_SPDT; SW_CuK_OS102011MA1QN1_SPDT_Angled

Connections:
+5V: DRV0_0.10 (M0), DRV0_0.11 (M1), DRV0_0.12 (M2), DRV0_0.13 (~RST), DRV0_0.14 (~SLP), DRV0_1.10 (M0), DRV0_1.11 (M1), DRV0_1.12 (M2), DRV0_1.13 (~RST), DRV0_1.14 (~SLP), DRV0_2.10 (M0), DRV0_2.11 (M1), DRV0_2.12 (M2), DRV0_2.13 (~RST), DRV0_2.14 (~SLP), DRV0_3.10 (M0), DRV0_3.11 (M1), DRV0_3.12 (M2), DRV0_3.13 (~RST), DRV0_3.14 (~SLP), DRV1_0.10 (M0), DRV1_0.11 (M1), DRV1_0.12 (M2), DRV1_0.13 (~RST), DRV1_0.14 (~SLP), DRV1_1.10 (M0), DRV1_1.11 (M1), DRV1_1.12 (M2), DRV1_1.13 (~RST), DRV1_1.14 (~SLP), DRV1_2.10 (M0), DRV1_2.11 (M1), DRV1_2.12 (M2), DRV1_2.13 (~RST), DRV1_2.14 (~SLP), DRV1_3.10 (M0), DRV1_3.11 (M1), DRV1_3.12 (M2), DRV1_3.13 (~RST), DRV1_3.14 (~SLP), DRV2_0.10 (M0), DRV2_0.11 (M1), DRV2_0.12 (M2), DRV2_0.13 (~RST), DRV2_0.14 (~SLP), DRV2_1.10 (M0), DRV2_1.11 (M1), DRV2_1.12 (M2), DRV2_1.13 (~RST), DRV2_1.14 (~SLP), DRV2_2.10 (M0), DRV2_2.11 (M1), DRV2_2.12 (M2), DRV2_2.13 (~RST), DRV2_2.14 (~SLP), DRV2_3.10 (M0), DRV2_3.11 (M1), DRV2_3.12 (M2), DRV2_3.13 (~RST), DRV2_3.14 (~SLP), GPIO.1, POW2.2, POW3.2, SPI.1, SW.2 (B)
+12V: DRV0_0.8 (VMOT), DRV0_1.8 (VMOT), DRV0_2.8 (VMOT), DRV0_3.8 (VMOT), DRV1_0.8 (VMOT), DRV1_1.8 (VMOT), DRV1_2.8 (VMOT), DRV1_3.8 (VMOT), DRV2_0.8 (VMOT), DRV2_1.8 (VMOT), DRV2_2.8 (VMOT), DRV2_3.8 (VMOT), FAN1.1, POW1.2
BUZZ: BUZZ.1 (-), MCU1.24 (G2)
CS: MCU1.29 (G5), SPI.5
D0: DRV0_0.16 (DIR), DRV1_0.16 (DIR), DRV2_0.16 (DIR), MCU1.12 (G14)
D1: DRV0_1.16 (DIR), DRV1_1.16 (DIR), DRV2_1.16 (DIR), MCU1.13 (G12)
D2: DRV0_2.16 (DIR), DRV1_2.16 (DIR), DRV2_2.16 (DIR), MCU1.15 (G13)
D3: DRV0_3.16 (DIR), DRV1_3.16 (DIR), DRV2_3.16 (DIR), MCU1.23 (G15)
EN0: DRV0_0.9 (~EN), DRV0_1.9 (~EN), DRV0_2.9 (~EN), DRV0_3.9 (~EN), MCU1.27 (G16)
EN1: DRV1_0.9 (~EN), DRV1_1.9 (~EN), DRV1_2.9 (~EN), DRV1_3.9 (~EN), MCU1.28 (G17)
EN2: DRV2_0.9 (~EN), DRV2_1.9 (~EN), DRV2_2.9 (~EN), DRV2_3.9 (~EN), MCU1.7 (G32)
GND: BUZZ.2 (+), DRV0_0.1 (GND), DRV0_0.7 (GND), DRV0_1.1 (GND), DRV0_1.7 (GND), DRV0_2.1 (GND), DRV0_2.7 (GND), DRV0_3.1 (GND), DRV0_3.7 (GND), DRV1_0.1 (GND), DRV1_0.7 (GND), DRV1_1.1 (GND), DRV1_1.7 (GND), DRV1_2.1 (GND), DRV1_2.7 (GND), DRV1_3.1 (GND), DRV1_3.7 (GND), DRV2_0.1 (GND), DRV2_0.7 (GND), DRV2_1.1 (GND), DRV2_1.7 (GND), DRV2_2.1 (GND), DRV2_2.7 (GND), DRV2_3.1 (GND), DRV2_3.7 (GND), FAN1.2, GPIO.4, MCU1.14 (GND), MCU1.32 (GND), MCU1.38 (GND), POW1.1, POW2.1, POW3.1, SPI.6
MISO: MCU1.31 (G19), SPI.3
MOSI: MCU1.37 (G23), SPI.2
unnamed: DRV0_0.4 (A1), M0_0.4
unnamed: DRV0_0.3 (A2), M0_0.3
unnamed: DRV0_0.5 (B1), M0_0.2
unnamed: DRV0_0.6 (B2), M0_0.1
unnamed: DRV0_1.4 (A1), M0_1.4
unnamed: DRV0_1.3 (A2), M0_1.3
unnamed: DRV0_1.5 (B1), M0_1.2
unnamed: DRV0_1.6 (B2), M0_1.1
unnamed: DRV0_2.4 (A1), M0_2.4
unnamed: DRV0_2.3 (A2), M0_2.3
unnamed: DRV0_2.5 (B1), M0_2.2
unnamed: DRV0_2.6 (B2), M0_2.1
unnamed: DRV0_3.4 (A1), M0_3.4
unnamed: DRV0_3.3 (A2), M0_3.3
unnamed: DRV0_3.5 (B1), M0_3.2
unnamed: DRV0_3.6 (B2), M0_3.1
unnamed: DRV1_0.4 (A1), M1_0.4
unnamed: DRV1_0.3 (A2), M1_0.3
unnamed: DRV1_0.5 (B1), M1_0.2
unnamed: DRV1_0.6 (B2), M1_0.1
unnamed: DRV1_1.4 (A1), M1_1.4
unnamed: DRV1_1.3 (A2), M1_1.3
unnamed: DRV1_1.5 (B1), M1_1.2
unnamed: DRV1_1.6 (B2), M1_1.1
unnamed: DRV1_2.4 (A1), M1_2.4
unnamed: DRV1_2.3 (A2), M1_2.3
unnamed: DRV1_2.5 (B1), M1_2.2
unnamed: DRV1_2.6 (B2), M1_2.1
unnamed: DRV1_3.4 (A1), M1_3.4
unnamed: DRV1_3.3 (A2), M1_3.3
unnamed: DRV1_3.5 (B1), M1_3.2
unnamed: DRV1_3.6 (B2), M1_3.1
unnamed: DRV2_0.4 (A1), M2_0.4
unnamed: DRV2_0.3 (A2), M2_0.3
unnamed: DRV2_0.5 (B1), M2_0.2
unnamed: DRV2_0.6 (B2), M2_0.1
unnamed: DRV2_1.4 (A1), M2_1.4
unnamed: DRV2_1.3 (A2), M2_1.3
unnamed: DRV2_1.5 (B1), M2_1.2
unnamed: DRV2_1.6 (B2), M2_1.1
unnamed: DRV2_2.4 (A1), M2_2.4
unnamed: DRV2_2.3 (A2), M2_2.3
unnamed: DRV2_2.5 (B1), M2_2.2
unnamed: DRV2_2.6 (B2), M2_2.1
unnamed: DRV2_3.4 (A1), M2_3.4
unnamed: DRV2_3.3 (A2), M2_3.3
unnamed: DRV2_3.5 (B1), M2_3.2
unnamed: DRV2_3.6 (B2), M2_3.1
unnamed: GPIO.2, MCU1.26 (G4)
unnamed: GPIO.3, MCU1.25 (G0)
unnamed: MCU1.19 (V5), SW.1 (A)
S0: DRV0_0.15 (STEP), DRV1_0.15 (STEP), DRV2_0.15 (STEP), MCU1.8 (G33)
S1: DRV0_1.15 (STEP), DRV1_1.15 (STEP), DRV2_1.15 (STEP), MCU1.10 (G26)
S2: DRV0_2.15 (STEP), DRV1_2.15 (STEP), DRV2_2.15 (STEP), MCU1.9 (G25)
S3: DRV0_3.15 (STEP), DRV1_3.15 (STEP), DRV2_3.15 (STEP), MCU1.11 (G27)
SCK: MCU1.30 (G18), SPI.4
SCL: I2C.1, MCU1.36 (G22)
SDA: I2C.2, MCU1.33 (G21)
