JaimeBravoAlgaba/Helios_SoftRobot/Electrónica/Helios/Helios_PCB/Helios_emt/Helios_emt.kicad_pcb

## KiCad design Electrónica/Helios/Helios_PCB/Helios_emt/Helios_emt.kicad_pcb (2024-08-02)

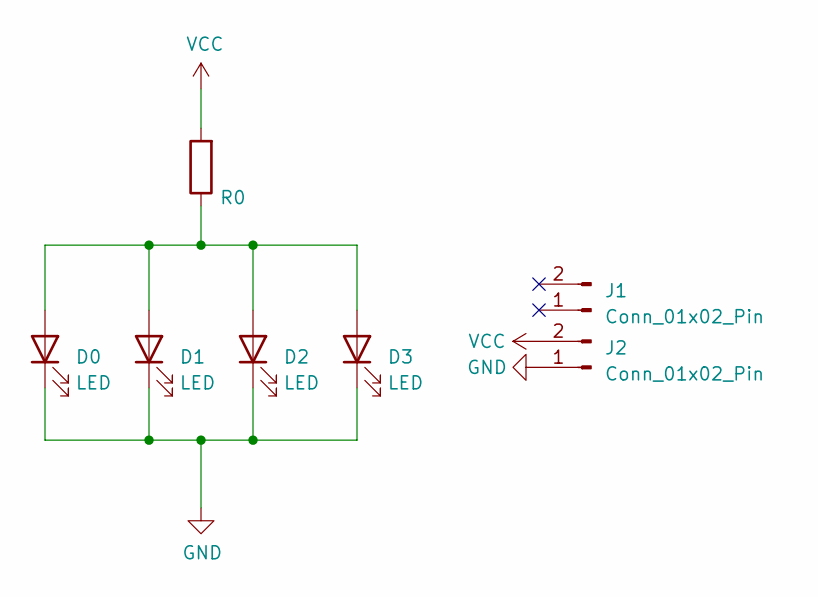
[picture p219: schematic Helios_emt.kicad_sch, Helios - Circuito Sensorizado]

Parts:
D0, D1, D2, D3: LED; LED_PLCC-2
J1, J2: Conn_01x02_Pin; AMASS_XT30U-F_1x02_P5.0mm_Vertical
R0: RL; R_0805_2012Metric

Connections:
GND: D0.1 (K), D1.1 (K), D2.1 (K), D3.1 (K), J2.1
unnamed: D0.2 (A), D1.2 (A), D2.2 (A), D3.2 (A), R0.1
VCC: J2.2, R0.2

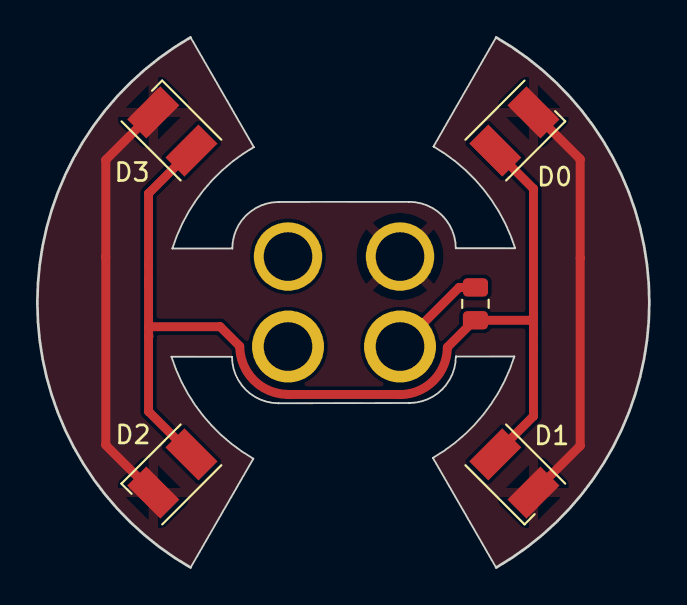
[picture p220: board Helios_emt.kicad_pcb from above]

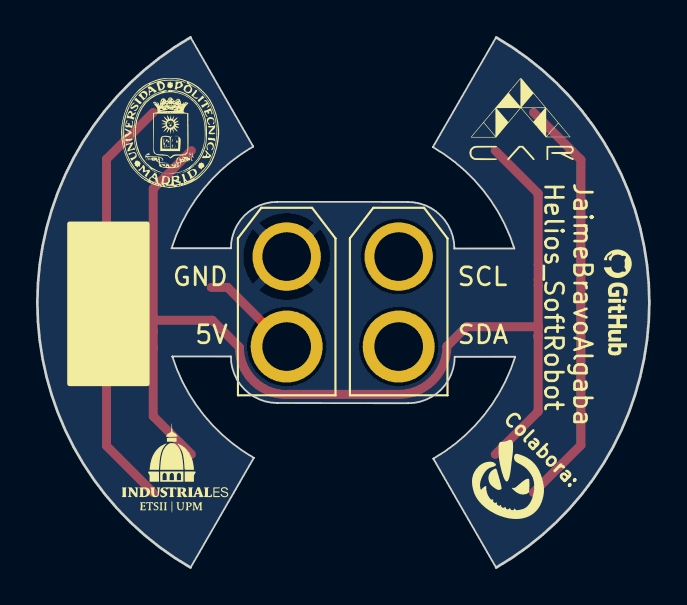
[picture p221: board Helios_emt.kicad_pcb from below]

Board: 2 copper layers, 34.0 x 29.5 mm, 7 parts (2 on the bottom side), 3 nets.
