JaimeBravoAlgaba/Helios_SoftRobot/Electrónica/Helios/Helios_PCB/Helios_rcv_00xx/Helios_rcv_00xx.kicad_pcb

## KiCad design Electrónica/Helios/Helios_PCB/Helios_rcv_00xx/Helios_rcv_00xx.kicad_pcb (2024-08-02)

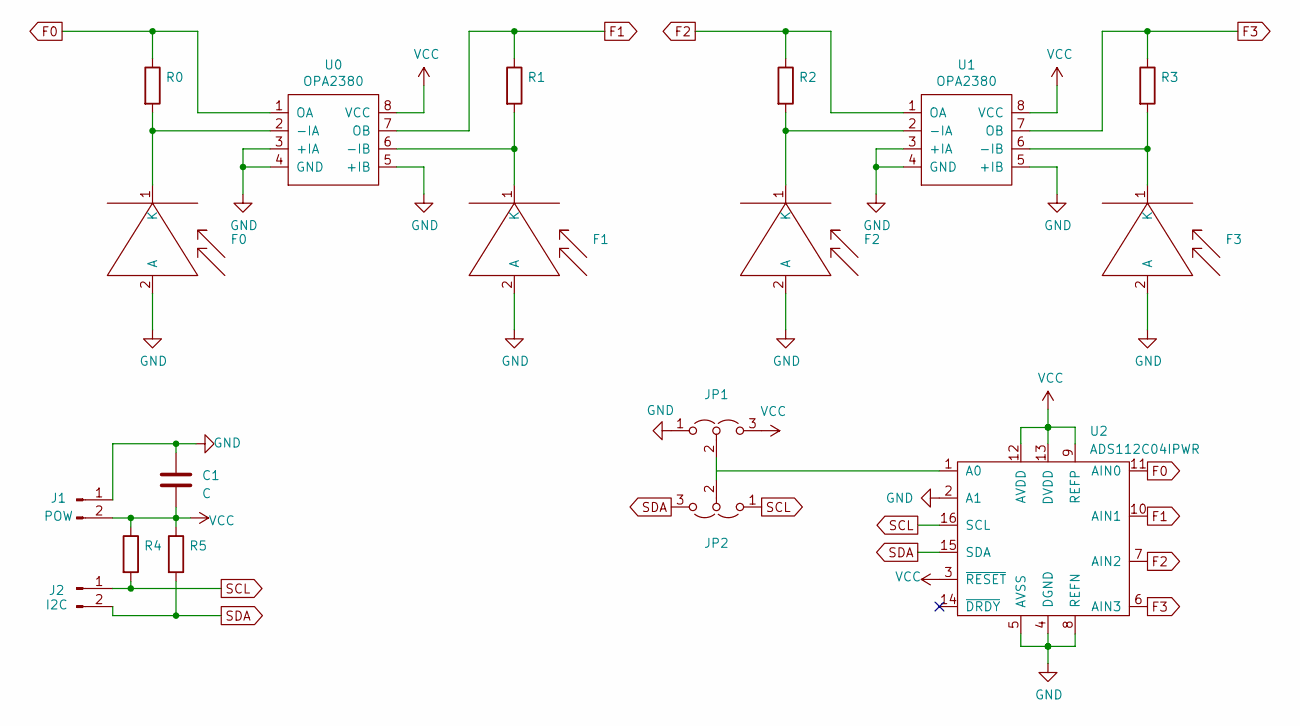
[picture p222: schematic Helios_rcv_00xx.kicad_sch, Helios - Circuito Sensorizado]

Parts:
C1: C; C_0805_2012Metric
F0, F1, F2, F3: SFH2704; SFH2704_Photodiode
J1: POW; XT30U-M_1x02_P5.0mm_Vertical
J2: I2C; XT30U-M_1x02_P5.0mm_Vertical
JP1, JP2: Jumper_3_Open; SolderJumper-3_P1.3mm_Open_Pad1.0x1.5mm
R0, R1, R2, R3, R4, R5: Rf; R_0805_2012Metric
U0, U1: OPA2380
U2: ADS112C04IPWR; TSSOP-16_4.4x5mm_P0.65mm

Connections:
F0: R0.1, U0.1 (OA), U2.11 (AIN0)
F1: R1.1, U0.7 (OB), U2.10 (AIN1)
F2: R2.1, U1.1 (OA), U2.7 (AIN2)
F3: R3.1, U1.7 (OB), U2.6 (AIN3)
GND: C1.1, F0.2 (A), F1.2 (A), F2.2 (A), F3.2 (A), J1.1, JP1.1 (A), U0.3 (+IA), U0.4 (GND), U0.5 (+IB), U1.3 (+IA), U1.4 (GND), U1.5 (+IB), U2.2 (A1), U2.4 (DGND), U2.5 (AVSS), U2.8 (REFN)
unnamed: F0.1 (K), R0.2, U0.2 (-IA)
unnamed: F1.1 (K), R1.2, U0.6 (-IB)
unnamed: F2.1 (K), R2.2, U1.2 (-IA)
unnamed: F3.1 (K), R3.2, U1.6 (-IB)
unnamed: JP1.2 (C), JP2.2 (C)
SCL: J2.1, JP2.1 (A), R4.2, U2.16 (SCL)
SDA: J2.2, JP2.3 (B), R5.2, U2.15 (SDA)
VCC: C1.2, J1.2, JP1.3 (B), R4.1, R5.1, U0.8 (VCC), U1.8 (VCC), U2.3 (~RESET), U2.9 (REFP), U2.12 (AVDD), U2.13 (DVDD)

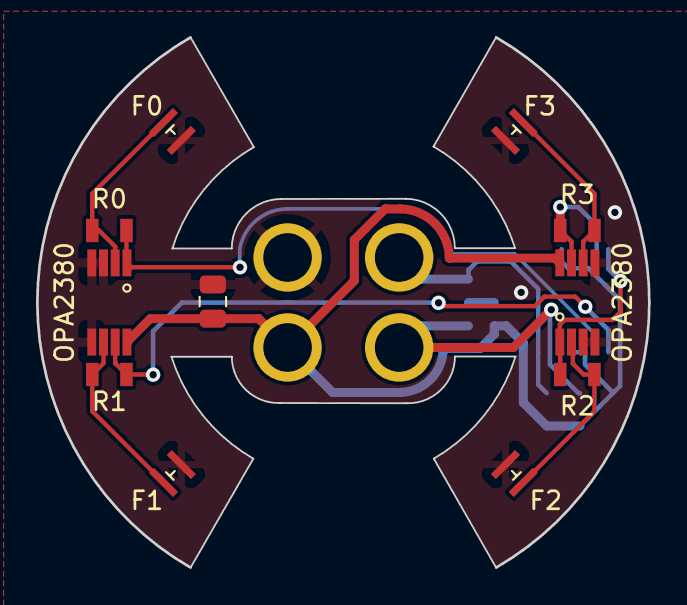
[picture p223: board Helios_rcv_00xx.kicad_pcb from above]

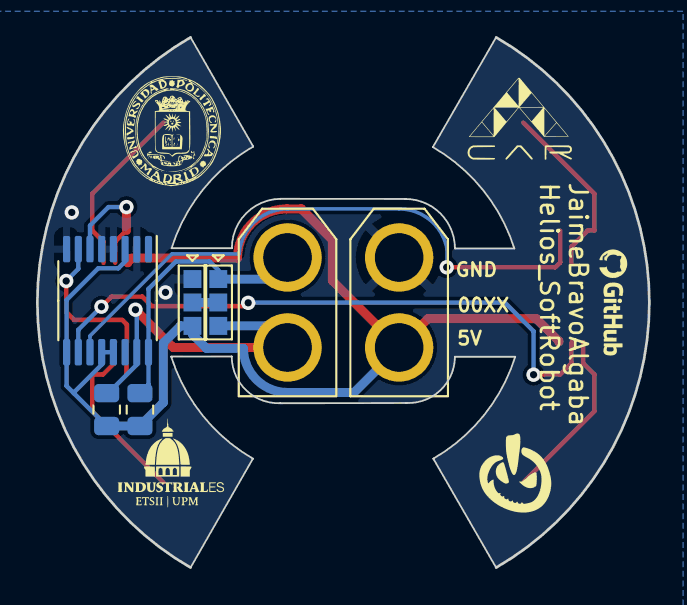
[picture p224: board Helios_rcv_00xx.kicad_pcb from below]

Board: 2 copper layers, 34.0 x 29.5 mm, 18 parts (7 on the bottom side), 13 nets.
