JaimeBravoAlgaba/Helios_SoftRobot/(commit log)

2022-05-23 Diseño PCB I_075
    [I-075_board.kicad_pcb, I-075_board.sch]
2022-06-05 Datasheet OPA2380 - Amplificador Operacional de Transimpedancia
2022-07-19 Pruebas WaveGuides
    [Helios_PCB.kicad_pcb, Helios_PCB.sch, Hembra_Molde_DiscoEpoxi.stl, MoldeCore.stl, MoldeSilicona_test.stl, WaveGuide_mold_a_10x2x50.stl, WaveGuide_mold_a_10x4x50.stl, WaveGuide_mold_a_6x1x50.stl]
2022-07-25 Añadidos planos PCB Helios/ Reorganización carpetas
2022-07-25 Helios PCB - Schematic
    [Helios_PCB.sch, I-075_board.kicad_pcb, I-075_board.sch]
2022-07-25 Helios -Sch Update
    [Helios_PCB.kicad_pcb, Helios_PCB.sch]
2022-07-25 Helios - Added Connectors
    [Helios_PCB.kicad_pcb, Helios_PCB.sch, SFH_2704_20190402_geometry.STEP]
2022-08-03 Helios: VCC routing
    [Helios_PCB.kicad_pcb, Helios_PCB.sch]
2022-08-03 Helios: Top Layer
    [Helios_PCB.kicad_pcb]
2022-08-05 Helios: Bot Layer Sch. (LEDs)
    [Helios_PCB.kicad_pcb, Helios_PCB.kicad_sch]
2022-08-07 Helios: Bot added resistance
    [Helios_PCB.kicad_pcb, Helios_PCB.kicad_sch]
2022-08-07 Revert "Helios: Bot added resistance"
    This reverts commit d0f403256e0d7f179b5c0dd237f6584baac4939d.
    [Helios_PCB.kicad_pcb, Helios_PCB.kicad_sch]
2022-08-07 Revert "Helios: Bot Layer Sch. (LEDs)"
    This reverts commit dca8e3bb9b15b9e1c7b2acfc811398ae5ce91dcf.
    [Helios_PCB.kicad_pcb, Helios_PCB.kicad_sch]
2022-08-07 Revert "Revert "Helios: Bot Layer Sch. (LEDs)""
    This reverts commit 5c5999d2bbe18ce28315539fce76e1635c27d7e8.
    [Helios_PCB.kicad_pcb, Helios_PCB.kicad_sch]
2022-08-07 Revert "Revert "Helios: Bot added resistance""
    This reverts commit b6ec3ea842d96de8bcfcf6a4a844077dd7699937.
    [Helios_PCB.kicad_pcb, Helios_PCB.kicad_sch]
2022-08-07 Helios: arreglados errores plano de tierra
    [Helios_PCB.kicad_pcb]
2022-08-07 Helios: Rev 1
    [Helios_PCB.kicad_pcb]
2022-08-08 Helios: Second Iteration (half pcb)
    [Helios_PCB.kicad_pcb, Helios_PCB.kicad_sch, Helios_PCB.sch]
2022-08-09 Helios: pcb 3dModel (draft)+Render
    [DraftShape.stl, Helios_PCB.kicad_pcb]
2022-09-16 Helios: Second Iter
    [Disk.cfg, HeliosAsm_1.cfg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]
2022-09-18 Helios: Iteration3
    [Helios_PCB-B_Cu.gbr, Helios_PCB-B_Mask.gbr, Helios_PCB-B_Paste.gbr, Helios_PCB-B_Silkscreen.gbr, Helios_PCB-Edge_Cuts.gbr, Helios_PCB-F_Cu.gbr, Helios_PCB-F_Mask.gbr, Helios_PCB-F_Paste.gbr]
2022-09-18 Helios: Receiver V1.3
    [Helios_PCB_receiver.kicad_pcb]
2022-09-18 Helios: Emitter V1.3
    [Helios_PCB-B_Cu.gbr, Helios_PCB-B_Mask.gbr, Helios_PCB-B_Paste.gbr, Helios_PCB-B_Silkscreen.gbr, Helios_PCB-Edge_Cuts.gbr, Helios_PCB-F_Cu.gbr, Helios_PCB-F_Mask.gbr, Helios_PCB-F_Paste.gbr]
2022-09-18 Helios: Updated Silkscreen
    [Helios_PCB_receiver.kicad_pcb]
2022-09-19 Helios: Flex Update
    [HeliosAsm_1.cfg]
2022-09-29 Helios: BOM
    [BOM_Helios.xlsx]
2022-10-08 Last changes V1.3
    [Helios_PCB_emitter.kicad_pcb, Helios_PCB_emitter.kicad_sch, Helios_PCB_receiver.kicad_pcb]
2022-10-08 Updated render
    [Helios_PCB_emitter.kicad_pcb, Helios_PCB_receiver.kicad_pcb]
2022-10-29 Second version of Disk_A
    [Disk.cfg]
2022-11-20 Modelo 3D Banco de Pruebas
2022-11-23 Helios_Section: added SPI Slave example
2023-03-13 SPI comms
2023-04-16 Helios Test Board code update
    [HeliosSection.cfg]
2023-04-16 Actuator class
2023-04-16 Sensor Print method
2023-07-26 SPI version
2023-07-26 I2C STABLE VERSION
2023-08-01 Added init method for ActuatorBench
2023-11-04 Added IMU fucntionality for MPU6050 module
2023-11-06 Added IMU PCB, female connection 3d model, assemblies. Error detected: invert connectors in PCB Male
    [AsmRobot.cfg, AsmSection.cfg, AsmSectionFemale.cfg, AsmSectionMale.cfg, Helios_PCB_Female.obj, Helios_PCB_Section.cfg, Helios_PCB_Section.obj, Helios_PCB_SectionV2.cfg]
2023-11-14 Helios Panel
    [AsmRobot.cfg, Helios_PCB_emitter.kicad_pcb, Helios_PCB_emitter.kicad_sch, Helios_PCB_female.kicad_pcb, Helios_PCB_female.kicad_sch, Helios_PCB_panel.kicad_pcb, Helios_PCB_panel.kicad_sch, Helios_PCB_receiver.kicad_pcb]
2023-11-14 PCBs ready for manufacturing
    [Helios_PCB_female.kicad_pcb, Helios_PCB_female.kicad_sch, Helios_PCB_panel.kicad_pcb, Helios_PCB_panel.kicad_sch]
2023-11-20 Minor Changes
    [Helios_PCB_emitter-B_Cu.gbr, Helios_PCB_emitter-B_Mask.gbr, Helios_PCB_emitter-B_Paste.gbr, Helios_PCB_emitter-B_Silkscreen.gbr, Helios_PCB_emitter-Edge_Cuts.gbr, Helios_PCB_emitter-F_Cu.gbr, Helios_PCB_emitter-F_Mask.gbr, Helios_PCB_emitter-F_Paste.gbr]
2023-11-20 V2.2 - BNO_055 IMU
    [Helios_PCB_female-B_Cu.gbr, Helios_PCB_female-B_Mask.gbr, Helios_PCB_female-B_Paste.gbr, Helios_PCB_female-B_Silkscreen.gbr, Helios_PCB_female-Edge_Cuts.gbr, Helios_PCB_female-F_Cu.gbr, Helios_PCB_female-F_Mask.gbr, Helios_PCB_female-F_Paste.gbr]
2023-11-22 Minor Updates
    [Helios_PCB_panel.kicad_sch]
2023-11-26 Added alluminium motor plate
    [Asm1.cfg, SoporteMotores.stp]
2023-11-27 Updated Nema Pulley actuator
    [Asm1.cfg]
2023-11-28 Major changes: reverted Object Oriented Programming. Implemented multiple section control. PCB bug detected: GPIO34 & GPIO35.
2024-01-08 Generated STL files for pulley actuator
    [Asm1.cfg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]
2024-01-28 Stable version
    [NemaPulley_PETG_2h17.3mf, NemaPulley_x4_PETG_2h17.3mf, NemaPulley_x4_PETG_9h18.3mf]
2024-04-02 Pre MicroROS
    [Asm1.cfg]
2024-04-30 Module CHaracterization
    [0x40_240423_1.csv, 0x40_240423_2.csv, 0x40_240423_3.csv, 0x41_240423_1.csv, 0x41_240423_2.csv, 0x41_240423_3.csv, 0x44_240423_1.csv, 0x44_240423_2.csv]
2024-08-02 Added render
    [Helios_rcv_00xx.kicad_pcb]
2024-08-03 Renders update
    [Helios_rcv_00xx.kicad_sch]
2024-08-04 Render explosionado
    [Disk.cfg, DraftShape.stl, HeliosAsm_1.cfg, HeliosSection.cfg]
2024-08-14 Helios Claw
2024-08-19 Reorganización Modelos3D
    [Adafruit_BNO055_AP214_pin.cfg, Amass_XT30UPB-F.cfg, Amass_XT30UPB-M.cfg, Asm1.cfg, AsmRobot.cfg, AsmSection.cfg, AsmSectionFemale.cfg, AsmSectionMale.cfg]
2024-08-20 Instrucciones de Instalación MicroROS
2024-08-21 Actualizadas instrucciones de instalación
2024-08-22 Modo de lectura continuo
2024-08-24 Calibración y mejoras IA
    [0x40_1.xlsx, 0x40_2 - copia.xlsx, 0x40_2.xlsx, 0x40_240823_2.csv, 0x40_240823_3.csv, 0x40_240823_4.csv, 0x40_3.xlsx, 0x40_4.csv]
2024-08-26 IA reentrenada
    [0x40_2 - copia.xlsx, 0x40_240423_1.csv, 0x40_240423_2.csv, 0x40_240423_3.csv, 0x40_240823_5.csv, 0x41_1.csv, 0x41_2.csv, 0x41_240423_1.csv]
2024-08-27 Updated sensor reading
2024-08-29 Actualización de los modelos de IA
    [0x40_1.xlsx, 0x40_2.xlsx, 0x40_240823_1.csv, 0x40_240823_2.csv, 0x40_240823_3.csv, 0x40_240823_4.csv, 0x40_3.xlsx, 0x40_4.csv]
2024-08-30 Actualizado script de análisis
2024-09-05 Pruebas de funcionamiento
2024-09-05 Añadidas instrucciones de instalación
2024-12-02 IMU Scan
2024-12-06 Caracterización con TOFs
    [data.csv]
2024-12-06 Update W
    [CE3PRO_worm_gear.3mf]
2024-12-10 Processing and filtering of TOF data
    [0x4A_241207_1.csv, 0x4A_241207_2.csv, 0x4A_241207_3.csv, data.csv]
2024-12-10 Test data
    [0x4A_241207_4.csv, data.csv]
2025-01-09 Remove brackets
    [0x4A_250109_445_1.csv]
2025-01-13 Trained model V3
    [0x4A_250109_1.csv, 0x4A_250109_2.csv, 0x4A_250109_3.csv, 0x4A_250109_350_1.csv, 0x4A_250109_415_1.csv, 0x4A_250109_415_2.csv, 0x4A_250109_415_3.csv, 0x4A_250109_415_4.csv]
2025-01-14 Reorganizado el código
2025-01-14 MAE for each PCC Parameter
    [abs_error_phi.csv]
2025-04-07 Añadido filtro de media a L
    [0x4A_250109_test_corrected.csv, 0x4A_250109_train_corrected.csv, Helios_Module.cfg, Helios_Module_section.cfg]
